Fredrik-Reinholdsen/Vesper/mechanics/Vesper.FCStd

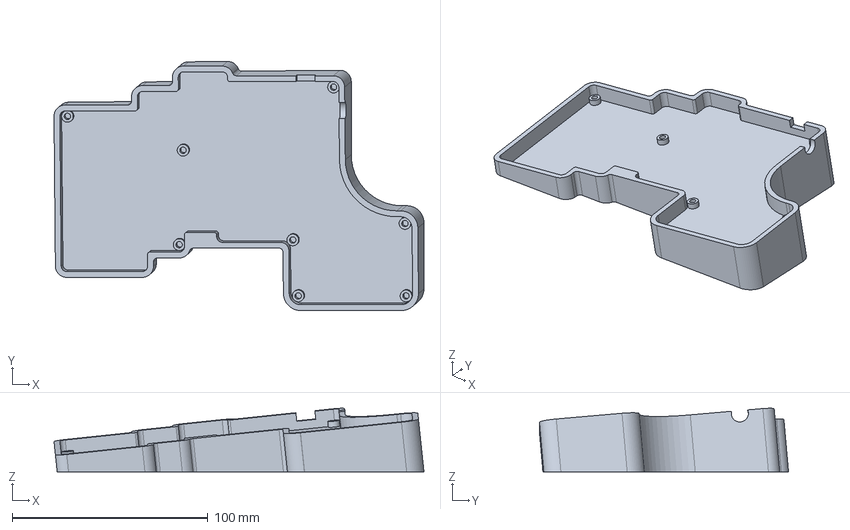
[picture p1: CAD file, 2026-06-29]
mechanics/Vesper.FCStd
189.0 x 127.3 x 32.5 mm
