Fredrik-Reinholdsen/Vesper/mechanics/Vesper_L_Top.FCStd

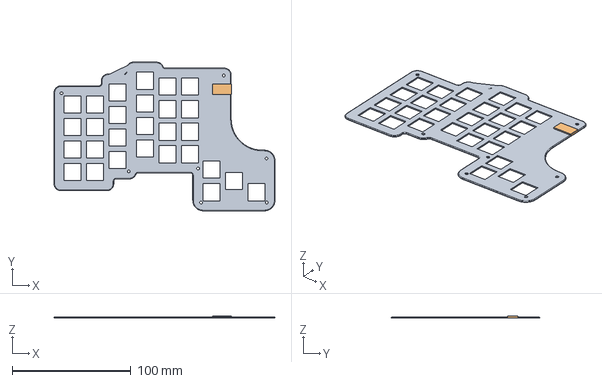
[picture p2: CAD file, 2026-06-29]
mechanics/Vesper_L_Top.FCStd
186.4 x 125.4 x 2.00 mm
TRRSBody
