Fredrik-Reinholdsen/Vesper/(list of files, cad)

Other CAD files:
mechanics/Vesper-L.stl
