Fredrik-Reinholdsen/Vesper/electronics/Schematic.pdf/Kallisto_V2.pdf

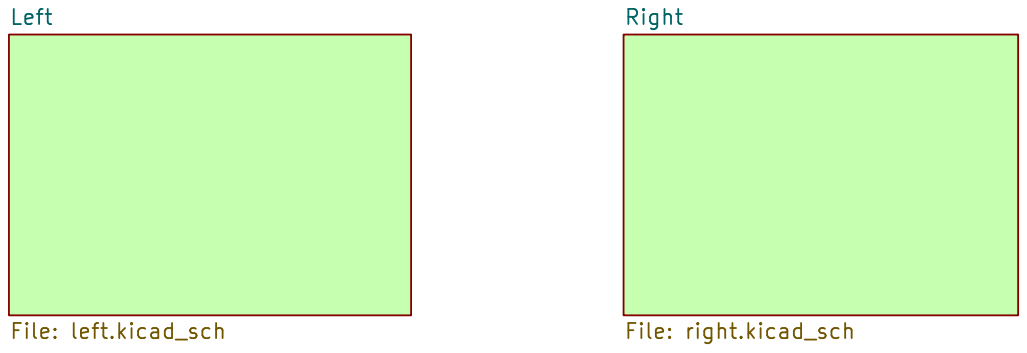
[picture p3: page 1]

Id: 1/5 Title: File: Kallisto_V2.kicad_sch Sheet: /

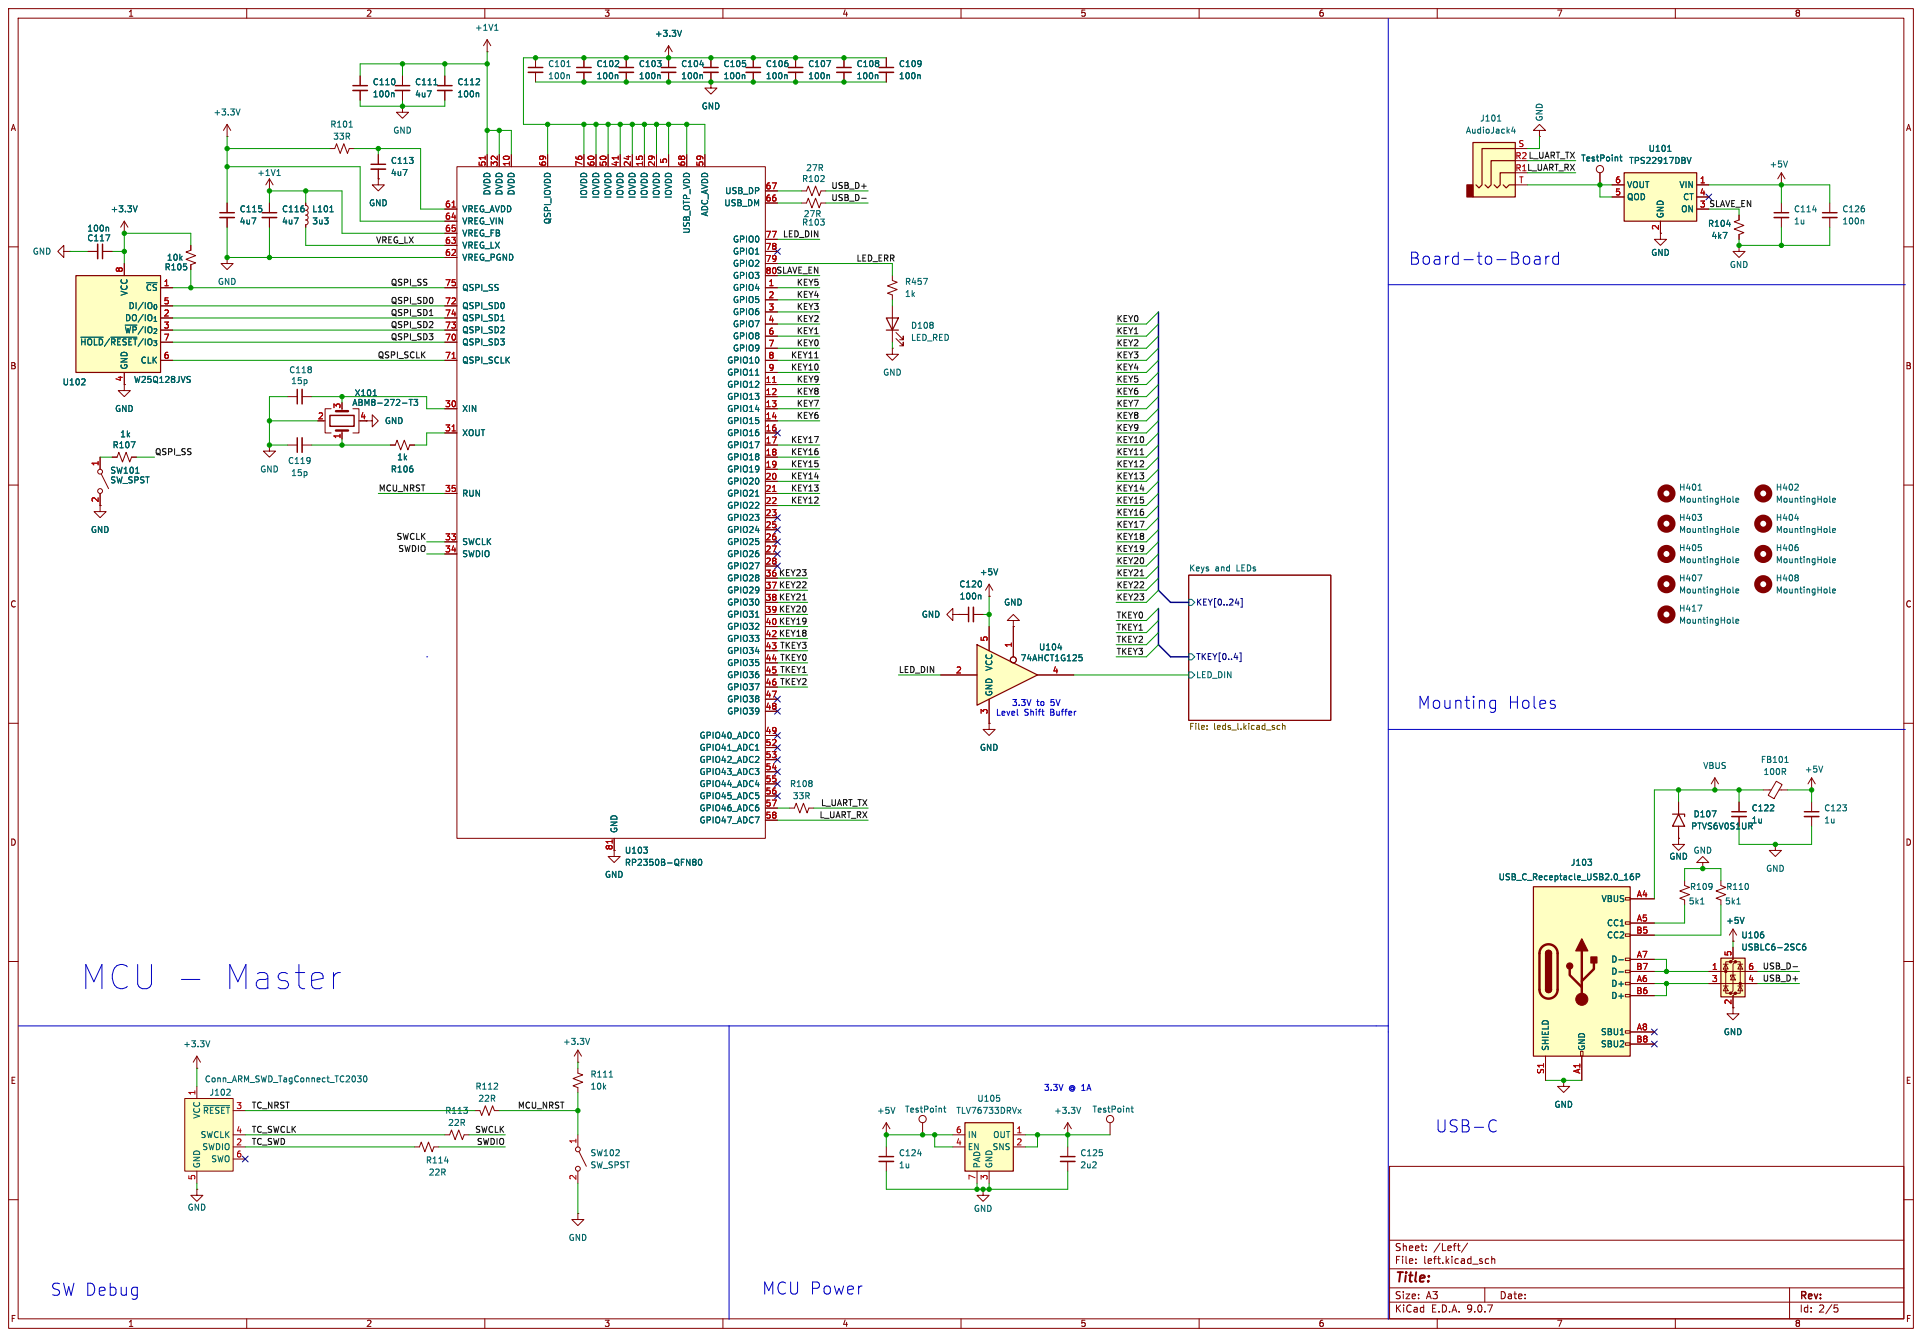
[picture p4: page 2]

4 U103 RP2350B-QFN80 GND 81 VREG_AVDD 61 VREG_VIN 64 VREG_FB 65 VREG_LX 63 VREG_PGND 62 QSPI_SS 75 QSPI_SD0 72 QSPI_SD1 74 QSPI_SD2 73 QSPI_SD3 70 QSPI_SCLK 71 XIN 30 XOUT 31 RUN 35 SWCLK 33 SWDIO 34 DVDD 51 DVDD 32 DVDD 10 QSPI_IOVDD 69 IOVDD 76 IOVDD 60 IOVDD 50 IOVDD 41 IOVDD 24 IOVDD 15 IOVDD 29 IOVDD

4k7 GND
H406 MountingHole H404 MountingHole H408 MountingHole H402 MountingHole GND GND

~{CS}1 DI/IO_{0}5 DO/IO_{1}2 ~{WP}/IO_{2} 3 ~{HOLD}/~{RESET}/IO_{3} 7 CLK 6 VCC

Level Shift Buffer GND

5 ~{RESET}3 SWCLK 4 SWDIO 2 SWO 6

Id: 2/5 Title: File: left.kicad_sch Sheet: /Left/

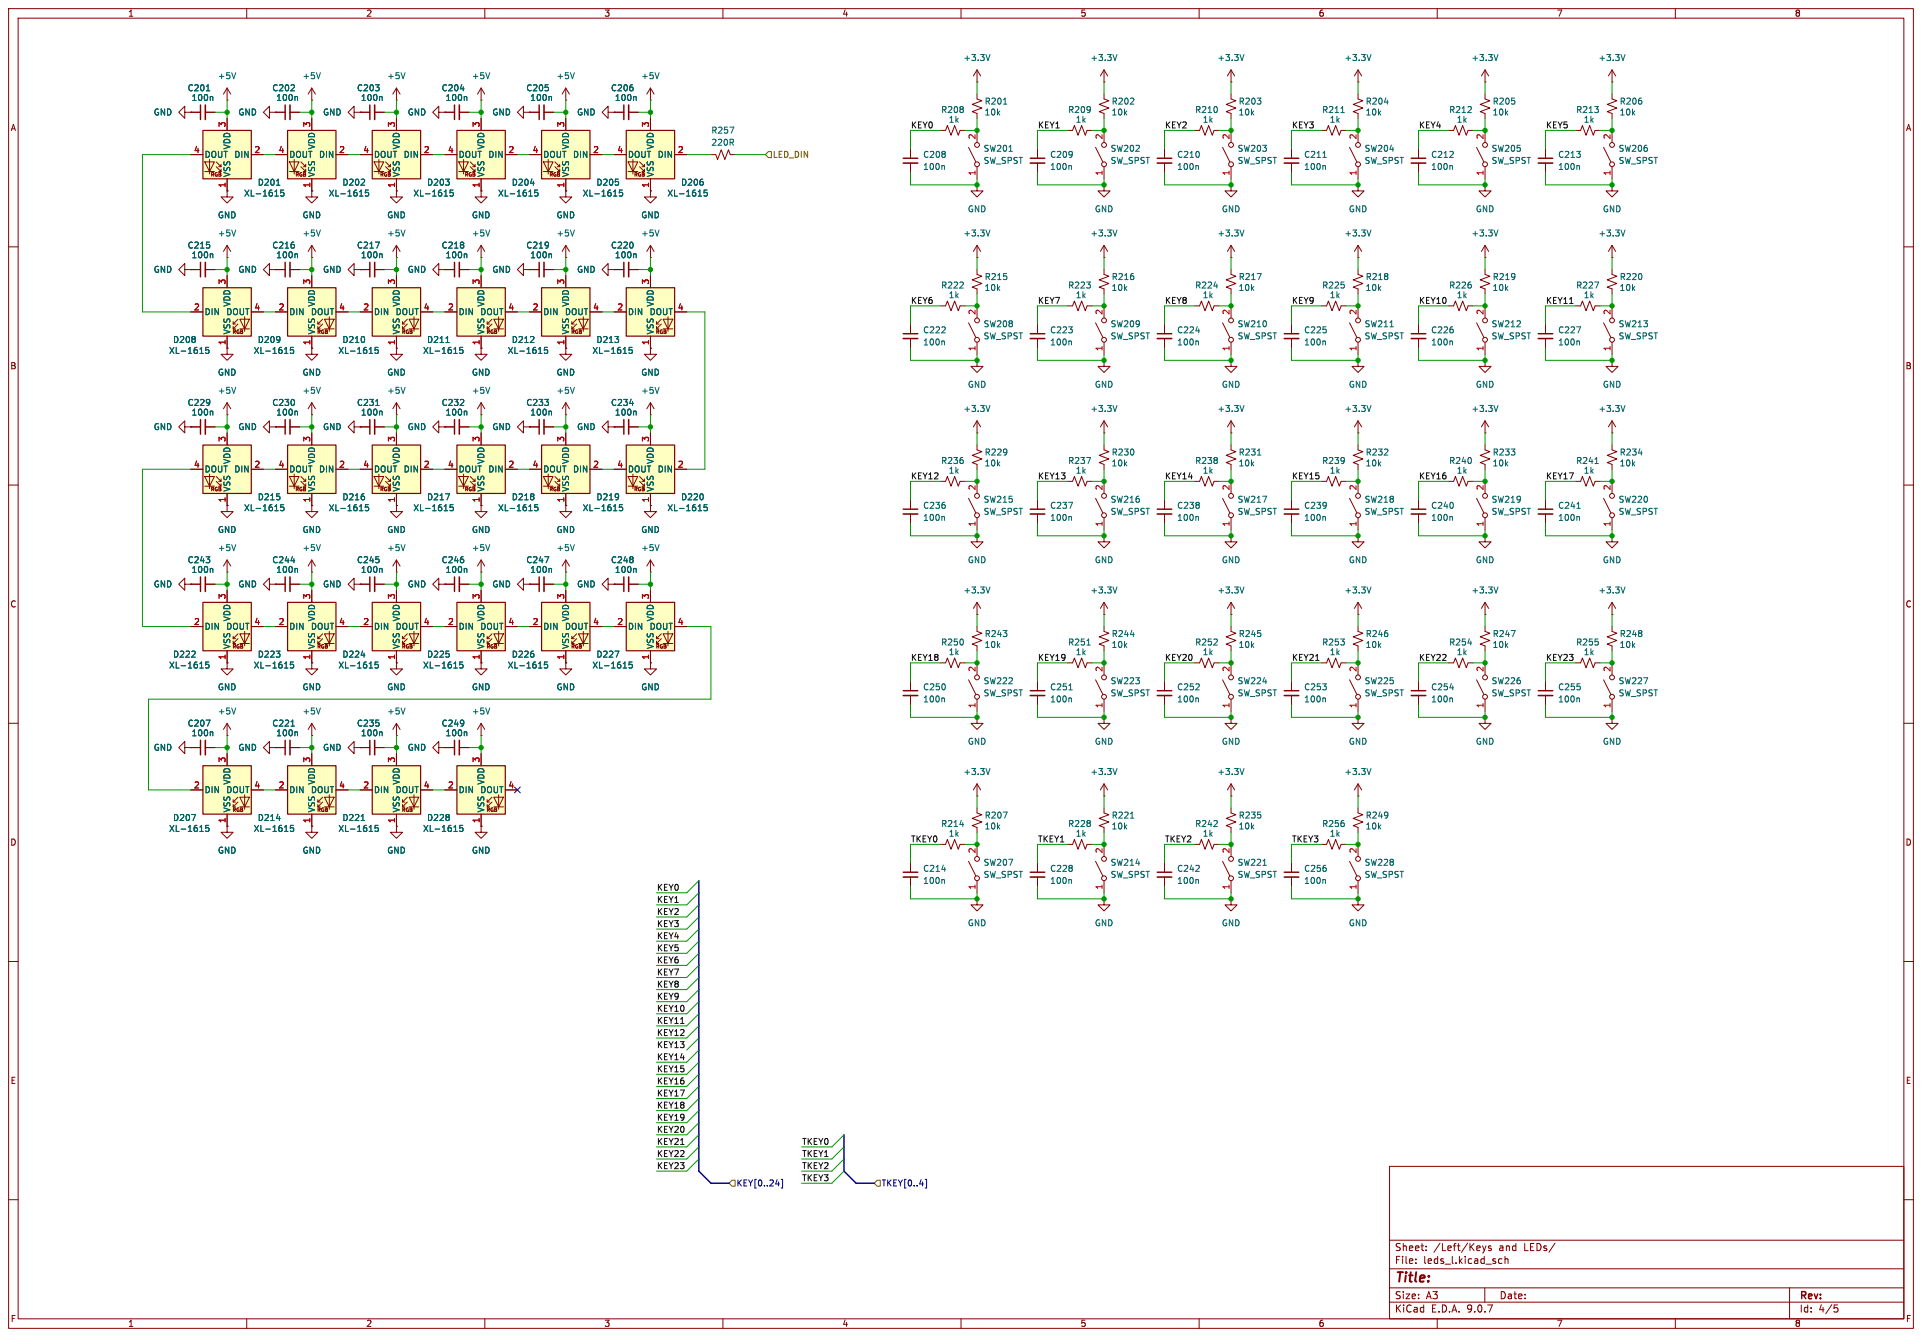
[picture p5: page 3]

1 DOUT 4 D204 XL-1615 GND GND

1 DOUT 4D206 XL-1615 DIN 2 VDD

1 DOUT 4 D208 XL-1615 GND GND

1 DOUT 4 D210 XL-1615 DIN 2 VDD

1 DOUT 4 D212 XL-1615 GND GND

1 DOUT 4 D215 XL-1615 +5V +5V GND GND GND GND

1 DOUT 4 GND GND GND GND

1 DOUT 4 D222 XL-1615 DIN 2 VDD

1 DOUT 4D224 XL-1615 DIN 2 VDD

1 DOUT 4 D225 XL-1615 DIN 2 VDD

1 DOUT 4D226 XL-1615 DIN 2 VDD

1 DOUT 4 GND GND GND

1 DOUT 4 D228 XL-1615 GND GND

1 DOUT 4D221 XL-1615 DIN 2 VDD

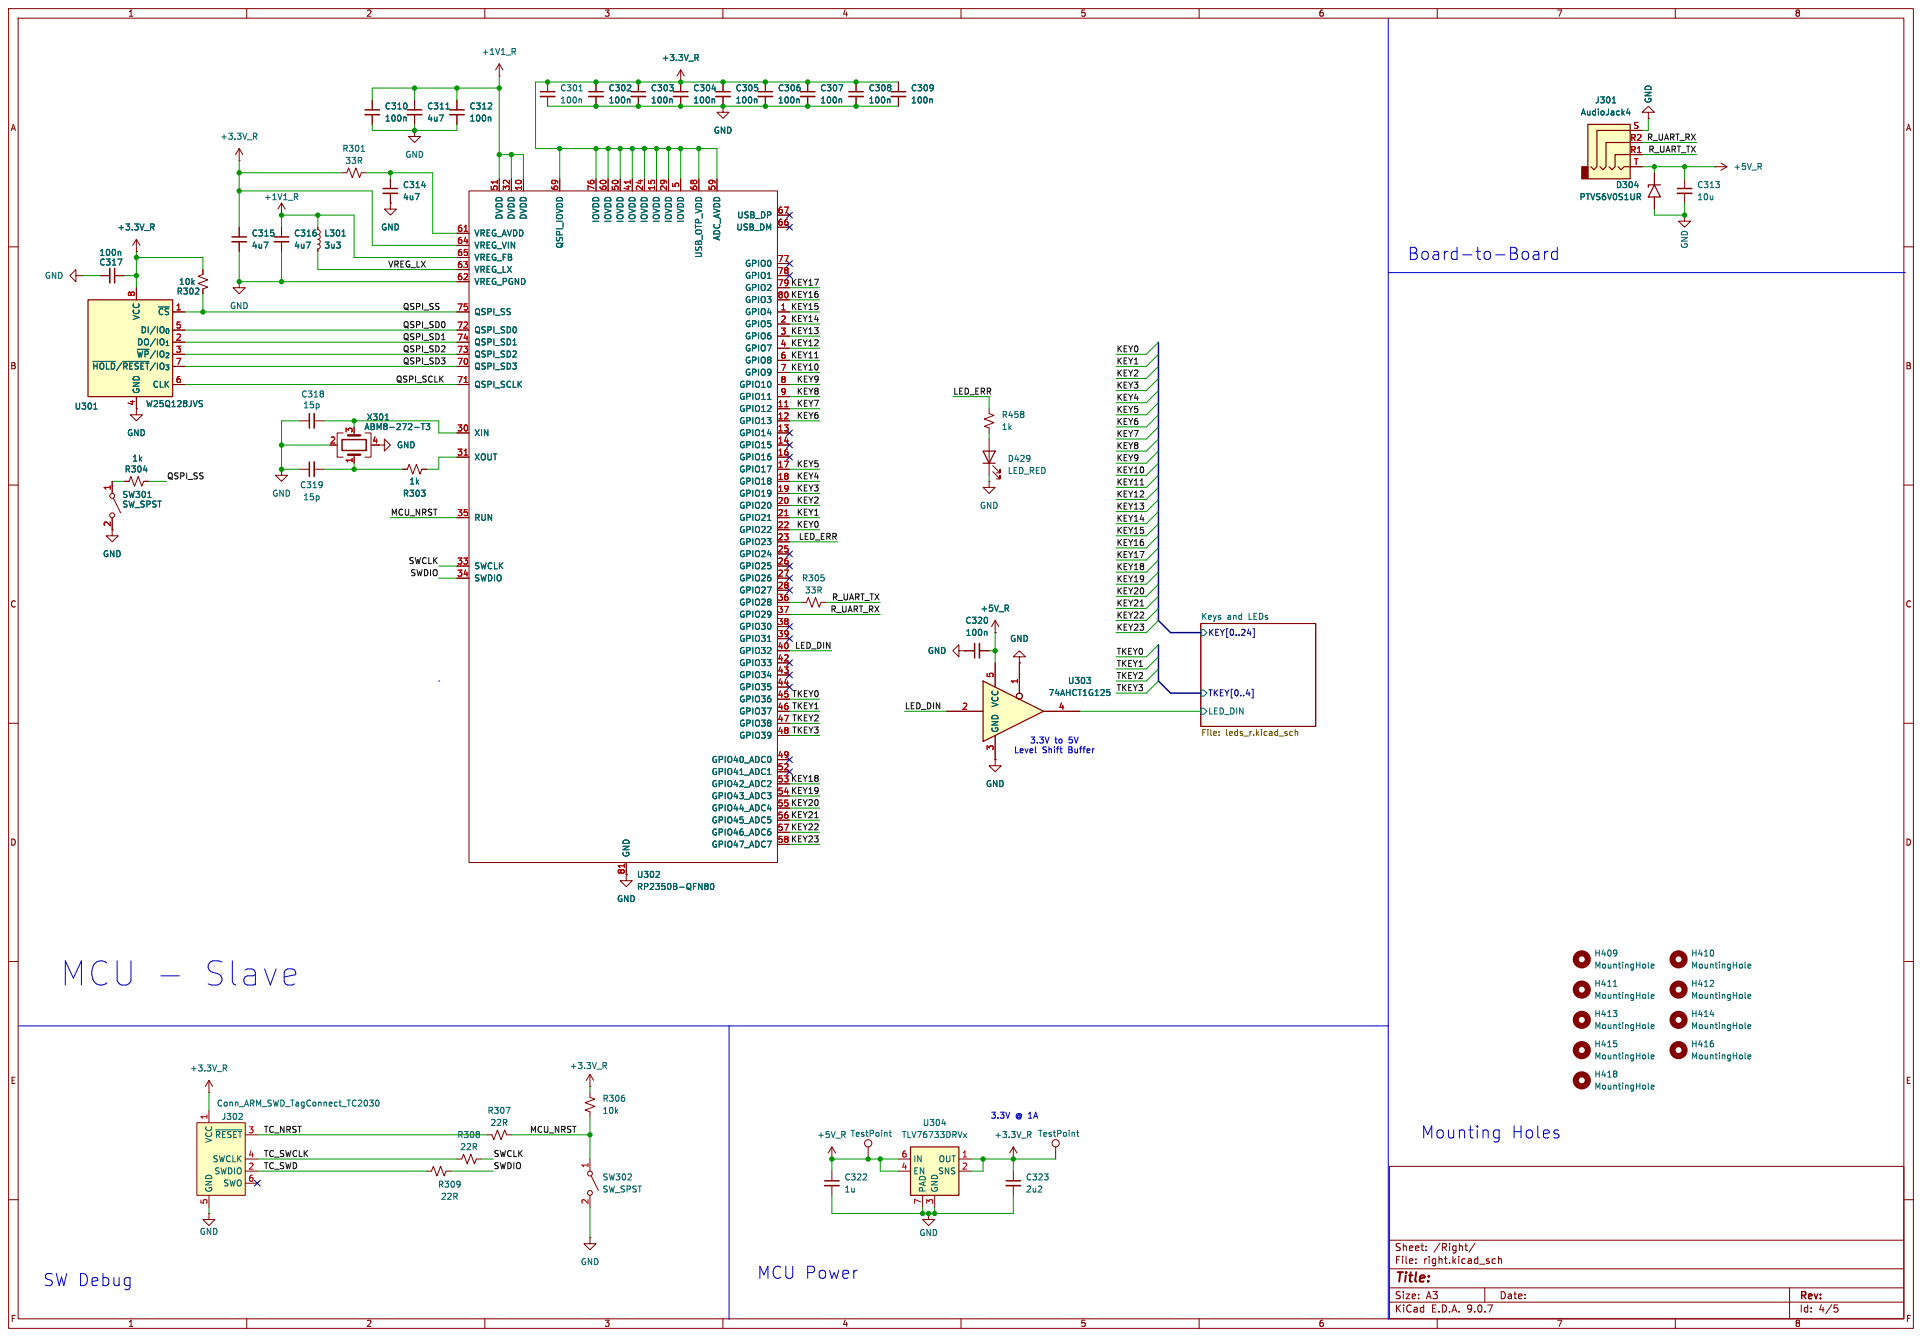
[picture p6: page 4]
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

Keys and LEDs File: leds_r.kicad_sch
KEY[0..24] LED_DIN

5 ~{RESET}3 SWCLK 4 SWDIO 2 SWO 6

Id: 4/5 Title: File: right.kicad_sch Sheet: /Right/

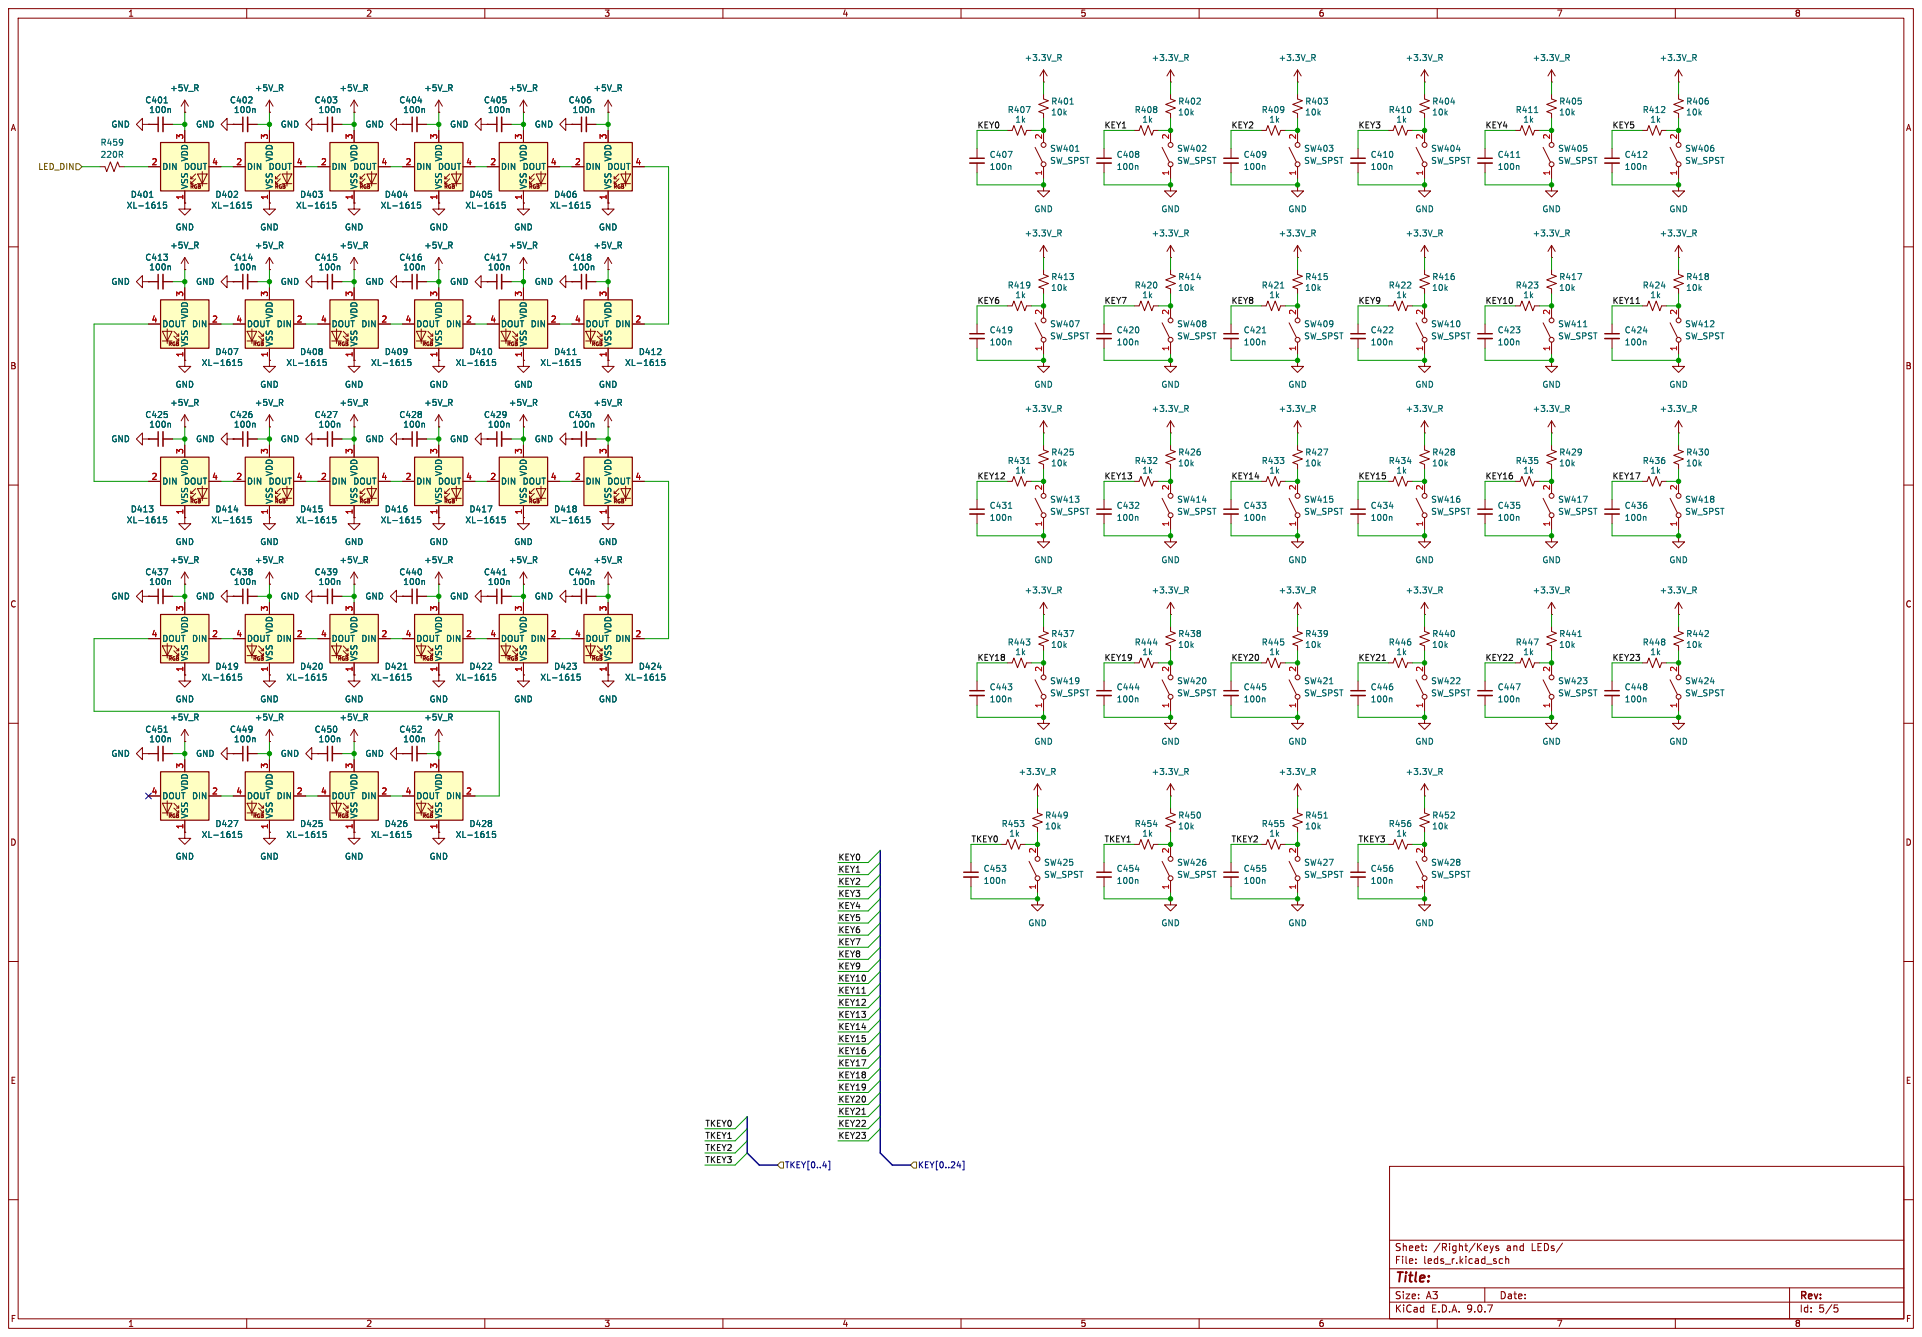
[picture p7: page 5]

1 DOUT 4 D409 XL-1615 DIN 2 VDD

1 DOUT 4 D419 XL-1615 GND GND

1 DOUT 4 D411 XL-1615 DIN 2 VDD

1 DOUT 4 GND GND GND

1 DOUT 4 D409 XL-1615 GND GND

1 DOUT 4 D414 XL-1615 GND GND

1 DOUT 4 D428 XL-1615 GND GND GND GND

1 DOUT 4 D420 XL-1615 DIN 2 VDD

1 DOUT 4 D423 XL-1615 DIN 2 VDD

1 DOUT 4 D422 XL-1615 GND GND
