Fredrik-Reinholdsen/Vesper/electronics/leds_l.kicad_sch

## KiCad design electronics/leds_l.kicad_sch (2026-06-29)

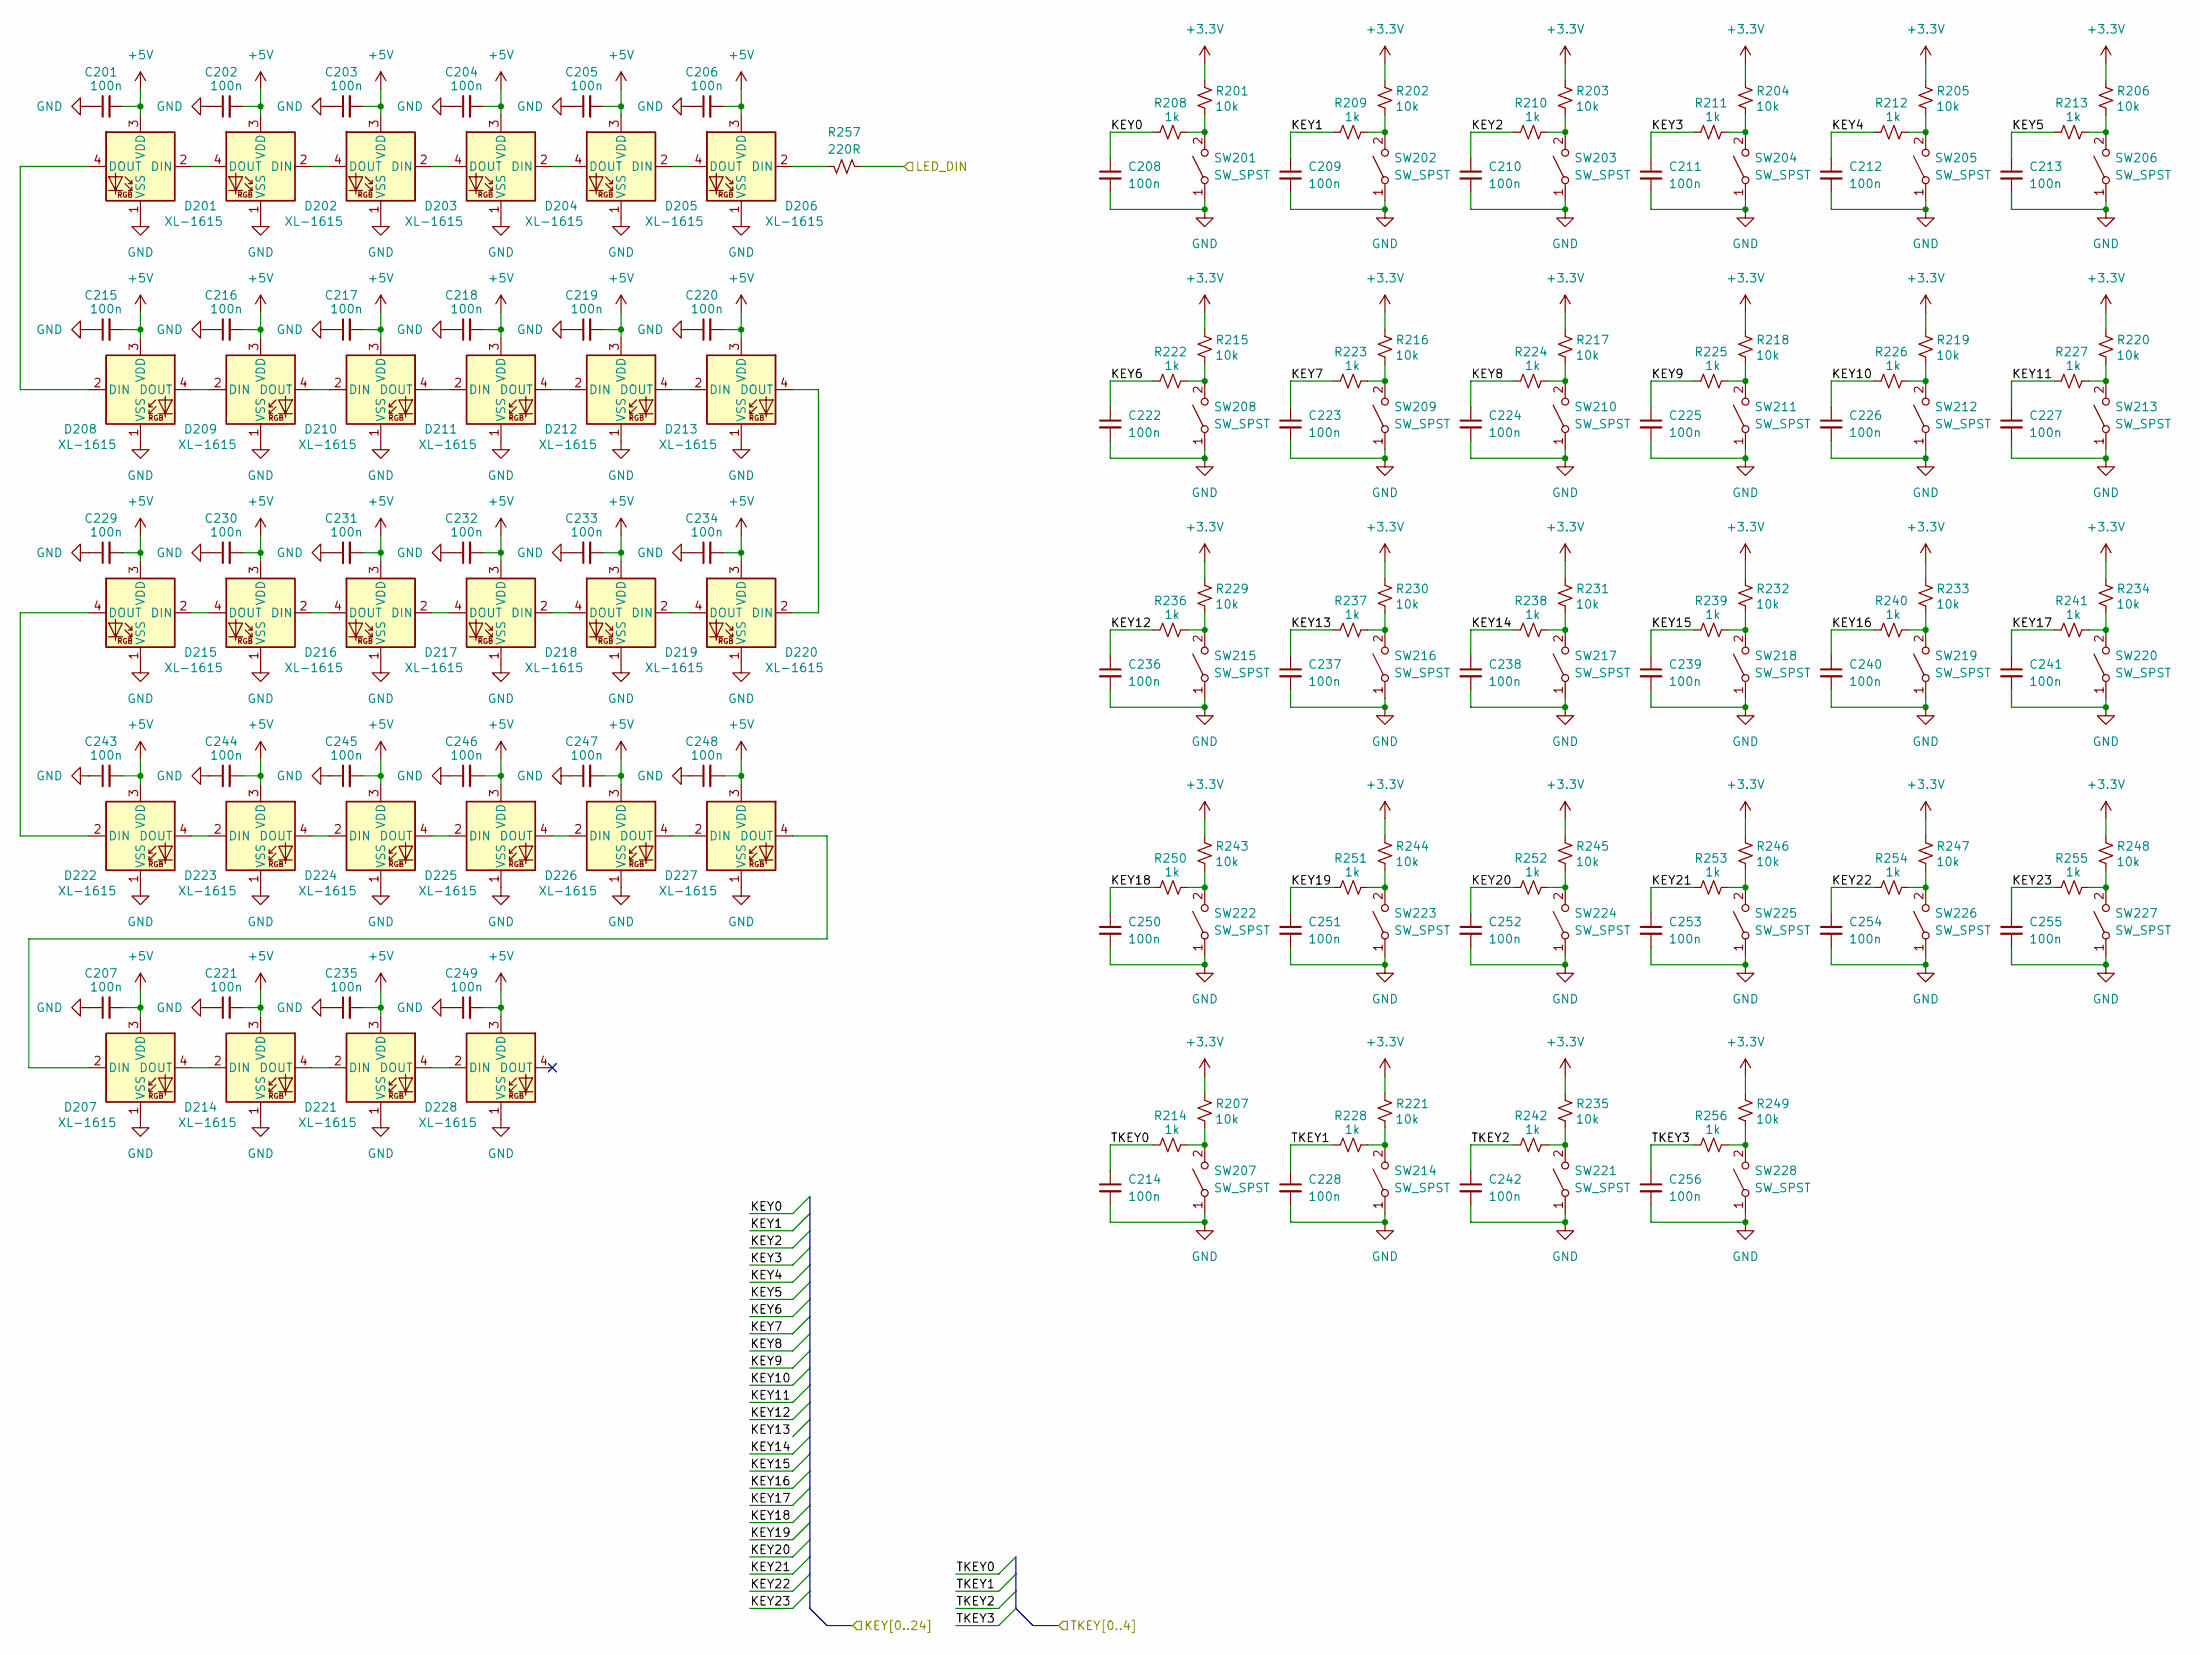
[picture p8: schematic leds_l.kicad_sch]

Parts:
C201, C202, C203, C204, C205, C206, C207, C208, C209, C210, C211, C212, C213, C214, C215, C216, C217, C218, C219, C220, C221, C222, C223, C224, C225, C226, C227, C228, C229, C230, C231, C232, C233, C234, C235, C236, C237, C238, C239, C240, C241, C242, C243, C244, C245, C246, C247, C248, C249, C250, C251, C252, C253, C254, C255, C256: 100n; C_0402_1005Metric; LCSC C1525
D201, D202, D203, D204, D205, D206, D207, D208, D209, D210, D211, D212, D213, D214, D215, D216, D217, D218, D219, D220, D221, D222, D223, D224, D225, D226, D227, D228: XL-1615; XL_1615RGBC; LCSC C5349954
R201, R202, R203, R204, R205, R206, R207, R215, R216, R217, R218, R219, R220, R221, R229, R230, R231, R232, R233, R234, R235, R243, R244, R245, R246, R247, R248, R249: 10k; R_0402_1005Metric; LCSC C25744
R208, R209, R210, R211, R212, R213, R214, R222, R223, R224, R225, R226, R227, R228, R236, R237, R238, R239, R240, R241, R242, R250, R251, R252, R253, R254, R255, R256: 1k; R_0402_1005Metric; LCSC C11702
R257: 220R; R_0402_1005Metric; LCSC C25091
SW201, SW202, SW203, SW204, SW205, SW206, SW207, SW208, SW209, SW210, SW211, SW212, SW213, SW214, SW215, SW216, SW217, SW218, SW219, SW220, SW221, SW222, SW223, SW224, SW225, SW226, SW227, SW228: SW_SPST; SW_PG1350

Connections:
+3.3V: R201.2, R202.2, R203.2, R204.2, R205.2, R206.2, R207.2, R215.2, R216.2, R217.2, R218.2, R219.2, R220.2, R221.2, R229.2, R230.2, R231.2, R232.2, R233.2, R234.2, R235.2, R243.2, R244.2, R245.2, R246.2, R247.2, R248.2, R249.2
+5V: C201.2, C202.2, C203.2, C204.2, C205.2, C206.2, C207.2, C215.2, C216.2, C217.2, C218.2, C219.2, C220.2, C221.2, C229.2, C230.2, C231.2, C232.2, C233.2, C234.2, C235.2, C243.2, C244.2, C245.2, C246.2, C247.2, C248.2, C249.2, D201.3 (VDD), D202.3 (VDD), D203.3 (VDD), D204.3 (VDD), D205.3 (VDD), D206.3 (VDD), D207.3 (VDD), D208.3 (VDD), D209.3 (VDD), D210.3 (VDD), D211.3 (VDD), D212.3 (VDD), D213.3 (VDD), D214.3 (VDD), D215.3 (VDD), D216.3 (VDD), D217.3 (VDD), D218.3 (VDD), D219.3 (VDD), D220.3 (VDD), D221.3 (VDD), D222.3 (VDD), D223.3 (VDD), D224.3 (VDD), D225.3 (VDD), D226.3 (VDD), D227.3 (VDD), D228.3 (VDD)
GND: C201.1, C202.1, C203.1, C204.1, C205.1, C206.1, C207.1, C208.2, C209.2, C210.2, C211.2, C212.2, C213.2, C214.2, C215.1, C216.1, C217.1, C218.1, C219.1, C220.1, C221.1, C222.2, C223.2, C224.2, C225.2, C226.2, C227.2, C228.2, C229.1, C230.1, C231.1, C232.1, C233.1, C234.1, C235.1, C236.2, C237.2, C238.2, C239.2, C240.2, C241.2, C242.2, C243.1, C244.1, C245.1, C246.1, C247.1, C248.1, C249.1, C250.2, C251.2, C252.2, C253.2, C254.2, C255.2, C256.2, D201.1 (VSS), D202.1 (VSS), D203.1 (VSS), D204.1 (VSS), D205.1 (VSS), D206.1 (VSS), D207.1 (VSS), D208.1 (VSS), D209.1 (VSS), D210.1 (VSS), D211.1 (VSS), D212.1 (VSS), D213.1 (VSS), D214.1 (VSS), D215.1 (VSS), D216.1 (VSS), D217.1 (VSS), D218.1 (VSS), D219.1 (VSS), D220.1 (VSS), D221.1 (VSS), D222.1 (VSS), D223.1 (VSS), D224.1 (VSS), D225.1 (VSS), D226.1 (VSS), D227.1 (VSS), D228.1 (VSS), SW201.1 (A), SW202.1 (A), SW203.1 (A), SW204.1 (A), SW205.1 (A), SW206.1 (A), SW207.1 (A), SW208.1 (A), SW209.1 (A), SW210.1 (A), SW211.1 (A), SW212.1 (A), SW213.1 (A), SW214.1 (A), SW215.1 (A), SW216.1 (A), SW217.1 (A), SW218.1 (A), SW219.1 (A), SW220.1 (A), SW221.1 (A), SW222.1 (A), SW223.1 (A), SW224.1 (A), SW225.1 (A), SW226.1 (A), SW227.1 (A), SW228.1 (A)
KEY0: C208.1, R208.1
KEY1: C209.1, R209.1
KEY2: C210.1, R210.1
KEY3: C211.1, R211.1
KEY4: C212.1, R212.1
KEY5: C213.1, R213.1
KEY6: C222.1, R222.1
KEY7: C223.1, R223.1
KEY8: C224.1, R224.1
KEY9: C225.1, R225.1
KEY10: C226.1, R226.1
KEY11: C227.1, R227.1
KEY12: C236.1, R236.1
KEY13: C237.1, R237.1
KEY14: C238.1, R238.1
KEY15: C239.1, R239.1
KEY16: C240.1, R240.1
KEY17: C241.1, R241.1
KEY18: C250.1, R250.1
KEY19: C251.1, R251.1
KEY20: C252.1, R252.1
KEY21: C253.1, R253.1
KEY22: C254.1, R254.1
KEY23: C255.1, R255.1
LED_DIN: R257.1
unnamed: D201.2 (DIN), D202.4 (DOUT)
unnamed: D201.4 (DOUT), D208.2 (DIN)
unnamed: D202.2 (DIN), D203.4 (DOUT)
unnamed: D203.2 (DIN), D204.4 (DOUT)
unnamed: D204.2 (DIN), D205.4 (DOUT)
unnamed: D205.2 (DIN), D206.4 (DOUT)
unnamed: D206.2 (DIN), R257.2
unnamed: D207.2 (DIN), D227.4 (DOUT)
unnamed: D207.4 (DOUT), D214.2 (DIN)
unnamed: D208.4 (DOUT), D209.2 (DIN)
unnamed: D209.4 (DOUT), D210.2 (DIN)
unnamed: D210.4 (DOUT), D211.2 (DIN)
unnamed: D211.4 (DOUT), D212.2 (DIN)
unnamed: D212.4 (DOUT), D213.2 (DIN)
unnamed: D213.4 (DOUT), D220.2 (DIN)
unnamed: D214.4 (DOUT), D221.2 (DIN)
unnamed: D215.2 (DIN), D216.4 (DOUT)
unnamed: D215.4 (DOUT), D222.2 (DIN)
unnamed: D216.2 (DIN), D217.4 (DOUT)
unnamed: D217.2 (DIN), D218.4 (DOUT)
unnamed: D218.2 (DIN), D219.4 (DOUT)
unnamed: D219.2 (DIN), D220.4 (DOUT)
unnamed: D221.4 (DOUT), D228.2 (DIN)
unnamed: D222.4 (DOUT), D223.2 (DIN)
unnamed: D223.4 (DOUT), D224.2 (DIN)
unnamed: D224.4 (DOUT), D225.2 (DIN)
unnamed: D225.4 (DOUT), D226.2 (DIN)
unnamed: D226.4 (DOUT), D227.2 (DIN)
unnamed: R201.1, R208.2, SW201.2 (B)
unnamed: R202.1, R209.2, SW202.2 (B)
unnamed: R203.1, R210.2, SW203.2 (B)
unnamed: R204.1, R211.2, SW204.2 (B)
unnamed: R205.1, R212.2, SW205.2 (B)
unnamed: R206.1, R213.2, SW206.2 (B)
unnamed: R207.1, R214.2, SW207.2 (B)
unnamed: R215.1, R222.2, SW208.2 (B)
unnamed: R216.1, R223.2, SW209.2 (B)
unnamed: R217.1, R224.2, SW210.2 (B)
unnamed: R218.1, R225.2, SW211.2 (B)
unnamed: R219.1, R226.2, SW212.2 (B)
unnamed: R220.1, R227.2, SW213.2 (B)
unnamed: R221.1, R228.2, SW214.2 (B)
unnamed: R229.1, R236.2, SW215.2 (B)
unnamed: R230.1, R237.2, SW216.2 (B)
unnamed: R231.1, R238.2, SW217.2 (B)
unnamed: R232.1, R239.2, SW218.2 (B)
unnamed: R233.1, R240.2, SW219.2 (B)
unnamed: R234.1, R241.2, SW220.2 (B)
unnamed: R235.1, R242.2, SW221.2 (B)
unnamed: R243.1, R250.2, SW222.2 (B)
unnamed: R244.1, R251.2, SW223.2 (B)
unnamed: R245.1, R252.2, SW224.2 (B)
unnamed: R246.1, R253.2, SW225.2 (B)
unnamed: R247.1, R254.2, SW226.2 (B)
unnamed: R248.1, R255.2, SW227.2 (B)
unnamed: R249.1, R256.2, SW228.2 (B)
TKEY0: C214.1, R214.1
TKEY1: C228.1, R228.1
TKEY2: C242.1, R242.1
TKEY3: C256.1, R256.1
