Fredrik-Reinholdsen/Vesper/electronics/leds_r.kicad_sch

## KiCad design electronics/leds_r.kicad_sch (2026-06-29)

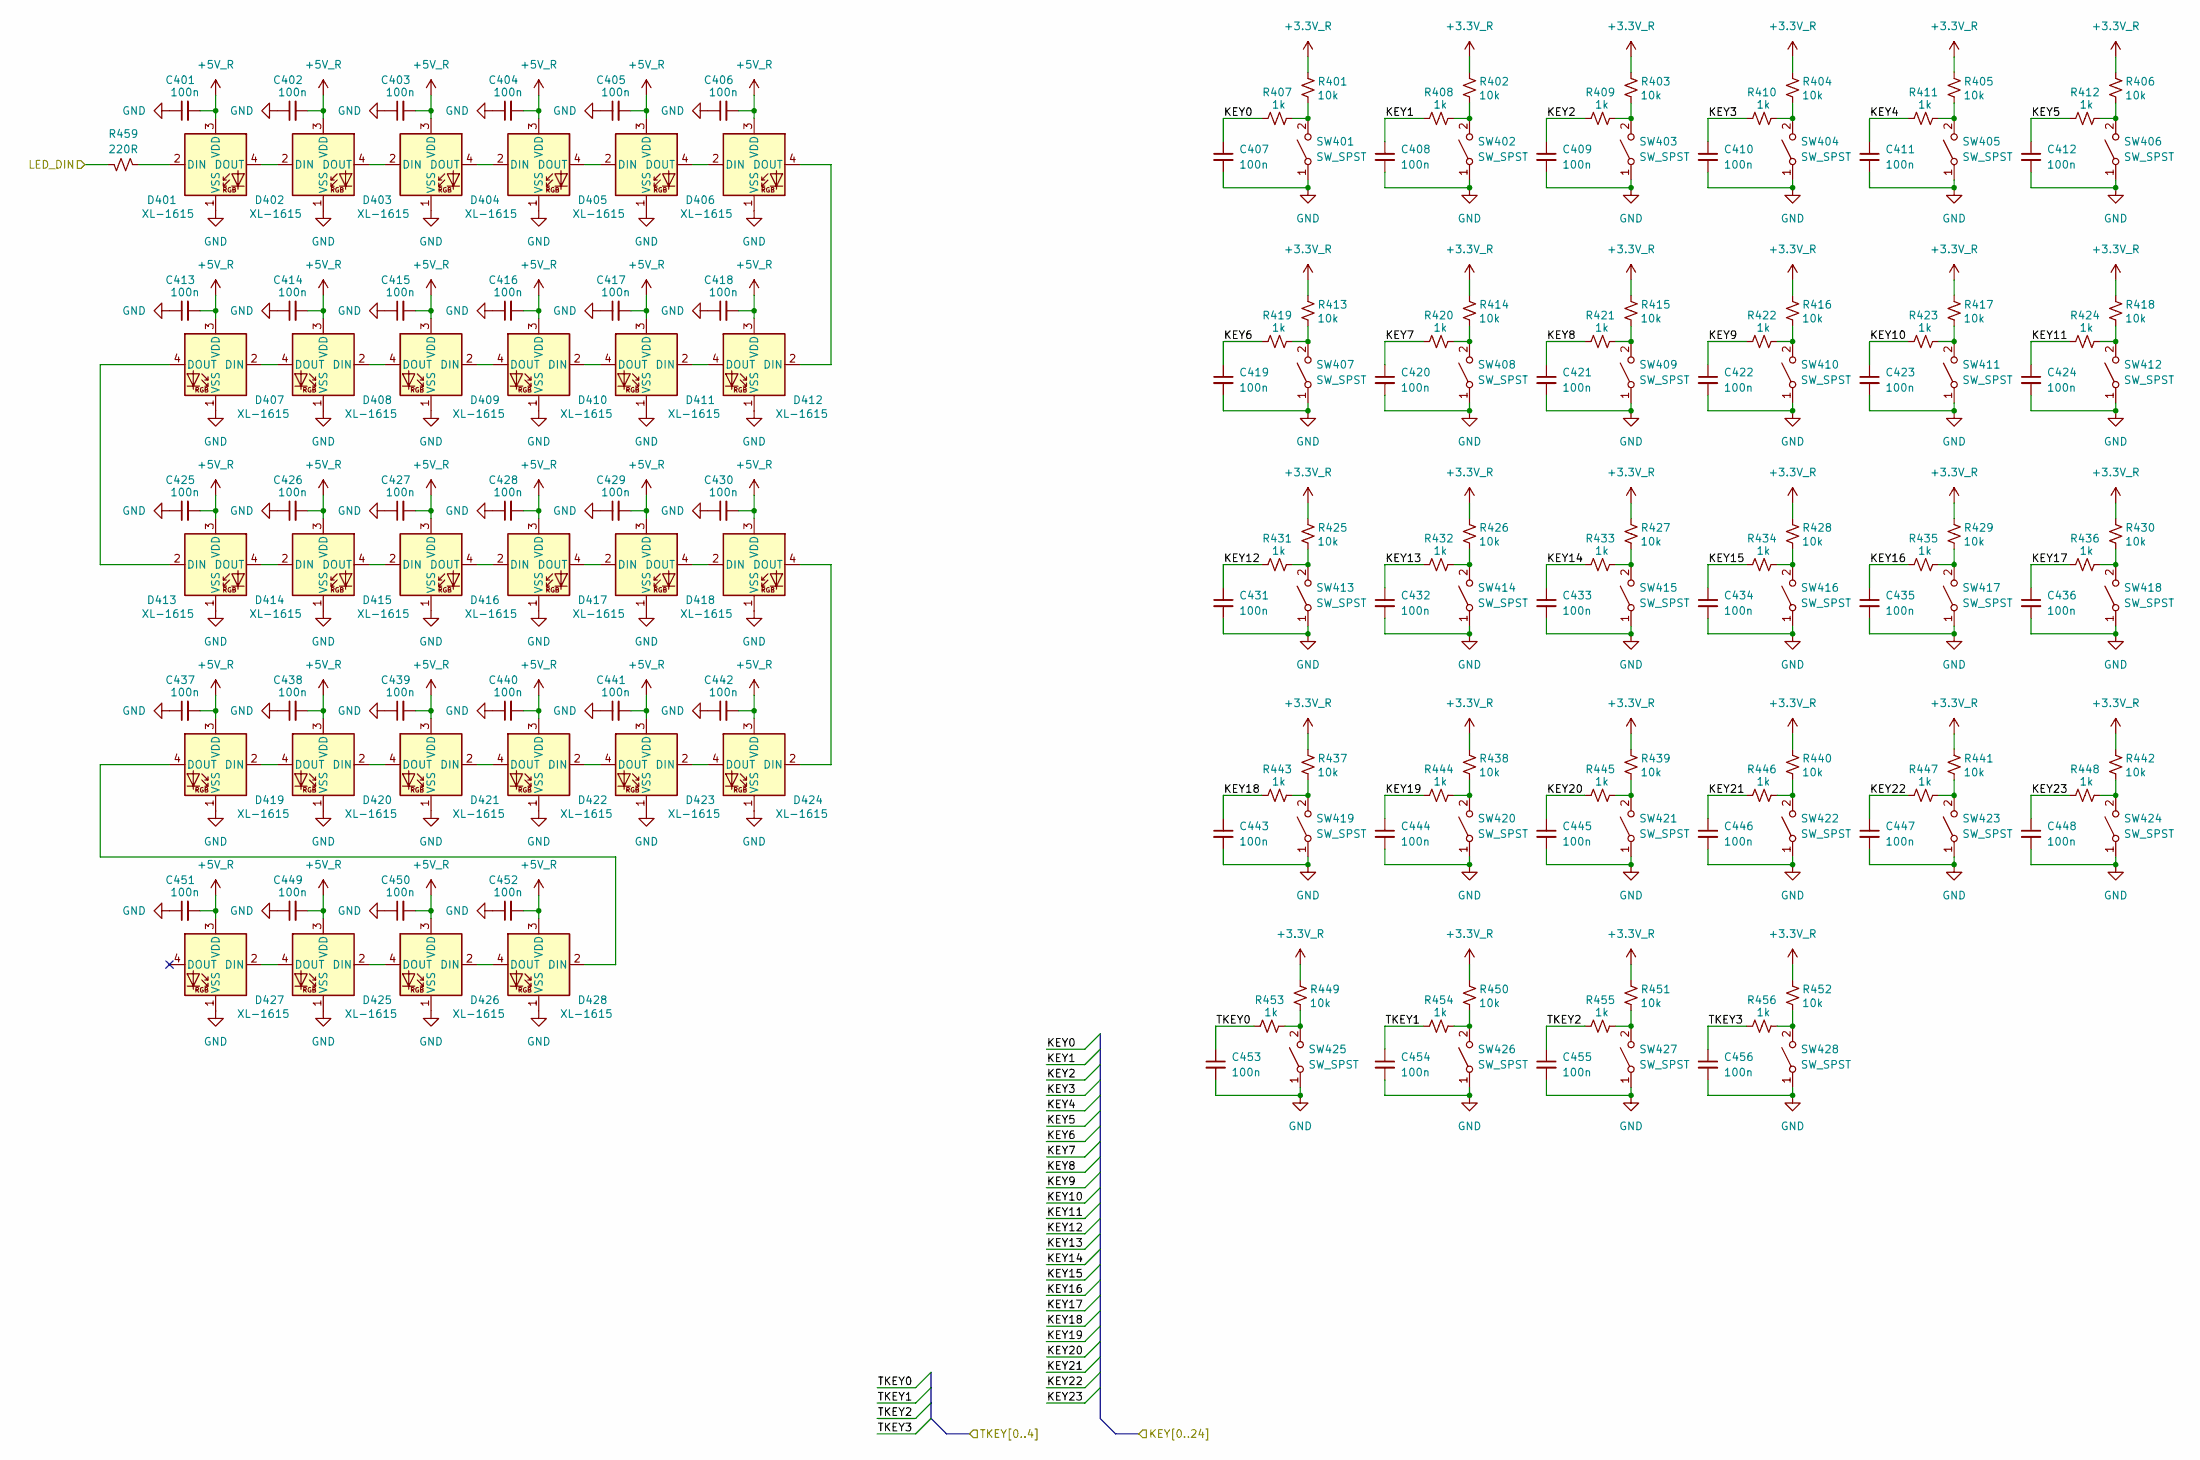
[picture p9: schematic leds_r.kicad_sch]

Parts:
C401, C402, C403, C404, C405, C406, C407, C408, C409, C410, C411, C412, C413, C414, C415, C416, C417, C418, C419, C420, C421, C422, C423, C424, C425, C426, C427, C428, C429, C430, C431, C432, C433, C434, C435, C436, C437, C438, C439, C440, C441, C442, C443, C444, C445, C446, C447, C448, C449, C450, C451, C452, C453, C454, C455, C456: 100n; C_0402_1005Metric; LCSC C1525
D401, D402, D403, D404, D405, D406, D407, D408, D409, D410, D411, D412, D413, D414, D415, D416, D417, D418, D419, D420, D421, D422, D423, D424, D425, D426, D427, D428: XL-1615; XL_1615RGBC; LCSC C5349954
R401, R402, R403, R404, R405, R406, R413, R414, R415, R416, R417, R418, R425, R426, R427, R428, R429, R430, R437, R438, R439, R440, R441, R442, R449, R450, R451, R452: 10k; R_0402_1005Metric; LCSC C25744
R407, R408, R409, R410, R411, R412, R419, R420, R421, R422, R423, R424, R431, R432, R433, R434, R435, R436, R443, R444, R445, R446, R447, R448, R453, R454, R455, R456: 1k; R_0402_1005Metric; LCSC C11702
R459: 220R; R_0402_1005Metric; LCSC C25091
SW401, SW402, SW403, SW404, SW405, SW406, SW407, SW408, SW409, SW410, SW411, SW412, SW413, SW414, SW415, SW416, SW417, SW418, SW419, SW420, SW421, SW422, SW423, SW424, SW425, SW426, SW427, SW428: SW_SPST; SW_PG1350

Connections:
+3.3V_R: R401.2, R402.2, R403.2, R404.2, R405.2, R406.2, R413.2, R414.2, R415.2, R416.2, R417.2, R418.2, R425.2, R426.2, R427.2, R428.2, R429.2, R430.2, R437.2, R438.2, R439.2, R440.2, R441.2, R442.2, R449.2, R450.2, R451.2, R452.2
+5V_R: C401.2, C402.2, C403.2, C404.2, C405.2, C406.2, C413.2, C414.2, C415.2, C416.2, C417.2, C418.2, C425.2, C426.2, C427.2, C428.2, C429.2, C430.2, C437.2, C438.2, C439.2, C440.2, C441.2, C442.2, C449.2, C450.2, C451.2, C452.2, D401.3 (VDD), D402.3 (VDD), D403.3 (VDD), D404.3 (VDD), D405.3 (VDD), D406.3 (VDD), D407.3 (VDD), D408.3 (VDD), D409.3 (VDD), D410.3 (VDD), D411.3 (VDD), D412.3 (VDD), D413.3 (VDD), D414.3 (VDD), D415.3 (VDD), D416.3 (VDD), D417.3 (VDD), D418.3 (VDD), D419.3 (VDD), D420.3 (VDD), D421.3 (VDD), D422.3 (VDD), D423.3 (VDD), D424.3 (VDD), D425.3 (VDD), D426.3 (VDD), D427.3 (VDD), D428.3 (VDD)
GND: C401.1, C402.1, C403.1, C404.1, C405.1, C406.1, C407.2, C408.2, C409.2, C410.2, C411.2, C412.2, C413.1, C414.1, C415.1, C416.1, C417.1, C418.1, C419.2, C420.2, C421.2, C422.2, C423.2, C424.2, C425.1, C426.1, C427.1, C428.1, C429.1, C430.1, C431.2, C432.2, C433.2, C434.2, C435.2, C436.2, C437.1, C438.1, C439.1, C440.1, C441.1, C442.1, C443.2, C444.2, C445.2, C446.2, C447.2, C448.2, C449.1, C450.1, C451.1, C452.1, C453.2, C454.2, C455.2, C456.2, D401.1 (VSS), D402.1 (VSS), D403.1 (VSS), D404.1 (VSS), D405.1 (VSS), D406.1 (VSS), D407.1 (VSS), D408.1 (VSS), D409.1 (VSS), D410.1 (VSS), D411.1 (VSS), D412.1 (VSS), D413.1 (VSS), D414.1 (VSS), D415.1 (VSS), D416.1 (VSS), D417.1 (VSS), D418.1 (VSS), D419.1 (VSS), D420.1 (VSS), D421.1 (VSS), D422.1 (VSS), D423.1 (VSS), D424.1 (VSS), D425.1 (VSS), D426.1 (VSS), D427.1 (VSS), D428.1 (VSS), SW401.1 (A), SW402.1 (A), SW403.1 (A), SW404.1 (A), SW405.1 (A), SW406.1 (A), SW407.1 (A), SW408.1 (A), SW409.1 (A), SW410.1 (A), SW411.1 (A), SW412.1 (A), SW413.1 (A), SW414.1 (A), SW415.1 (A), SW416.1 (A), SW417.1 (A), SW418.1 (A), SW419.1 (A), SW420.1 (A), SW421.1 (A), SW422.1 (A), SW423.1 (A), SW424.1 (A), SW425.1 (A), SW426.1 (A), SW427.1 (A), SW428.1 (A)
KEY0: C407.1, R407.1
KEY1: C408.1, R408.1
KEY2: C409.1, R409.1
KEY3: C410.1, R410.1
KEY4: C411.1, R411.1
KEY5: C412.1, R412.1
KEY6: C419.1, R419.1
KEY7: C420.1, R420.1
KEY8: C421.1, R421.1
KEY9: C422.1, R422.1
KEY10: C423.1, R423.1
KEY11: C424.1, R424.1
KEY12: C431.1, R431.1
KEY13: C432.1, R432.1
KEY14: C433.1, R433.1
KEY15: C434.1, R434.1
KEY16: C435.1, R435.1
KEY17: C436.1, R436.1
KEY18: C443.1, R443.1
KEY19: C444.1, R444.1
KEY20: C445.1, R445.1
KEY21: C446.1, R446.1
KEY22: C447.1, R447.1
KEY23: C448.1, R448.1
LED_DIN: R459.2
unnamed: D401.2 (DIN), R459.1
unnamed: D401.4 (DOUT), D402.2 (DIN)
unnamed: D402.4 (DOUT), D403.2 (DIN)
unnamed: D403.4 (DOUT), D404.2 (DIN)
unnamed: D404.4 (DOUT), D405.2 (DIN)
unnamed: D405.4 (DOUT), D406.2 (DIN)
unnamed: D406.4 (DOUT), D412.2 (DIN)
unnamed: D407.2 (DIN), D408.4 (DOUT)
unnamed: D407.4 (DOUT), D413.2 (DIN)
unnamed: D408.2 (DIN), D409.4 (DOUT)
unnamed: D409.2 (DIN), D410.4 (DOUT)
unnamed: D410.2 (DIN), D411.4 (DOUT)
unnamed: D411.2 (DIN), D412.4 (DOUT)
unnamed: D413.4 (DOUT), D414.2 (DIN)
unnamed: D414.4 (DOUT), D415.2 (DIN)
unnamed: D415.4 (DOUT), D416.2 (DIN)
unnamed: D416.4 (DOUT), D417.2 (DIN)
unnamed: D417.4 (DOUT), D418.2 (DIN)
unnamed: D418.4 (DOUT), D424.2 (DIN)
unnamed: D419.2 (DIN), D420.4 (DOUT)
unnamed: D419.4 (DOUT), D428.2 (DIN)
unnamed: D420.2 (DIN), D421.4 (DOUT)
unnamed: D421.2 (DIN), D422.4 (DOUT)
unnamed: D422.2 (DIN), D423.4 (DOUT)
unnamed: D423.2 (DIN), D424.4 (DOUT)
unnamed: D425.2 (DIN), D426.4 (DOUT)
unnamed: D425.4 (DOUT), D427.2 (DIN)
unnamed: D426.2 (DIN), D428.4 (DOUT)
unnamed: R401.1, R407.2, SW401.2 (B)
unnamed: R402.1, R408.2, SW402.2 (B)
unnamed: R403.1, R409.2, SW403.2 (B)
unnamed: R404.1, R410.2, SW404.2 (B)
unnamed: R405.1, R411.2, SW405.2 (B)
unnamed: R406.1, R412.2, SW406.2 (B)
unnamed: R413.1, R419.2, SW407.2 (B)
unnamed: R414.1, R420.2, SW408.2 (B)
unnamed: R415.1, R421.2, SW409.2 (B)
unnamed: R416.1, R422.2, SW410.2 (B)
unnamed: R417.1, R423.2, SW411.2 (B)
unnamed: R418.1, R424.2, SW412.2 (B)
unnamed: R425.1, R431.2, SW413.2 (B)
unnamed: R426.1, R432.2, SW414.2 (B)
unnamed: R427.1, R433.2, SW415.2 (B)
unnamed: R428.1, R434.2, SW416.2 (B)
unnamed: R429.1, R435.2, SW417.2 (B)
unnamed: R430.1, R436.2, SW418.2 (B)
unnamed: R437.1, R443.2, SW419.2 (B)
unnamed: R438.1, R444.2, SW420.2 (B)
unnamed: R439.1, R445.2, SW421.2 (B)
unnamed: R440.1, R446.2, SW422.2 (B)
unnamed: R441.1, R447.2, SW423.2 (B)
unnamed: R442.1, R448.2, SW424.2 (B)
unnamed: R449.1, R453.2, SW425.2 (B)
unnamed: R450.1, R454.2, SW426.2 (B)
unnamed: R451.1, R455.2, SW427.2 (B)
unnamed: R452.1, R456.2, SW428.2 (B)
TKEY0: C453.1, R453.1
TKEY1: C454.1, R454.1
TKEY2: C455.1, R455.1
TKEY3: C456.1, R456.1
