Fredrik-Reinholdsen/Vesper/electronics/left.kicad_sch

## KiCad design electronics/left.kicad_sch (2026-06-29)

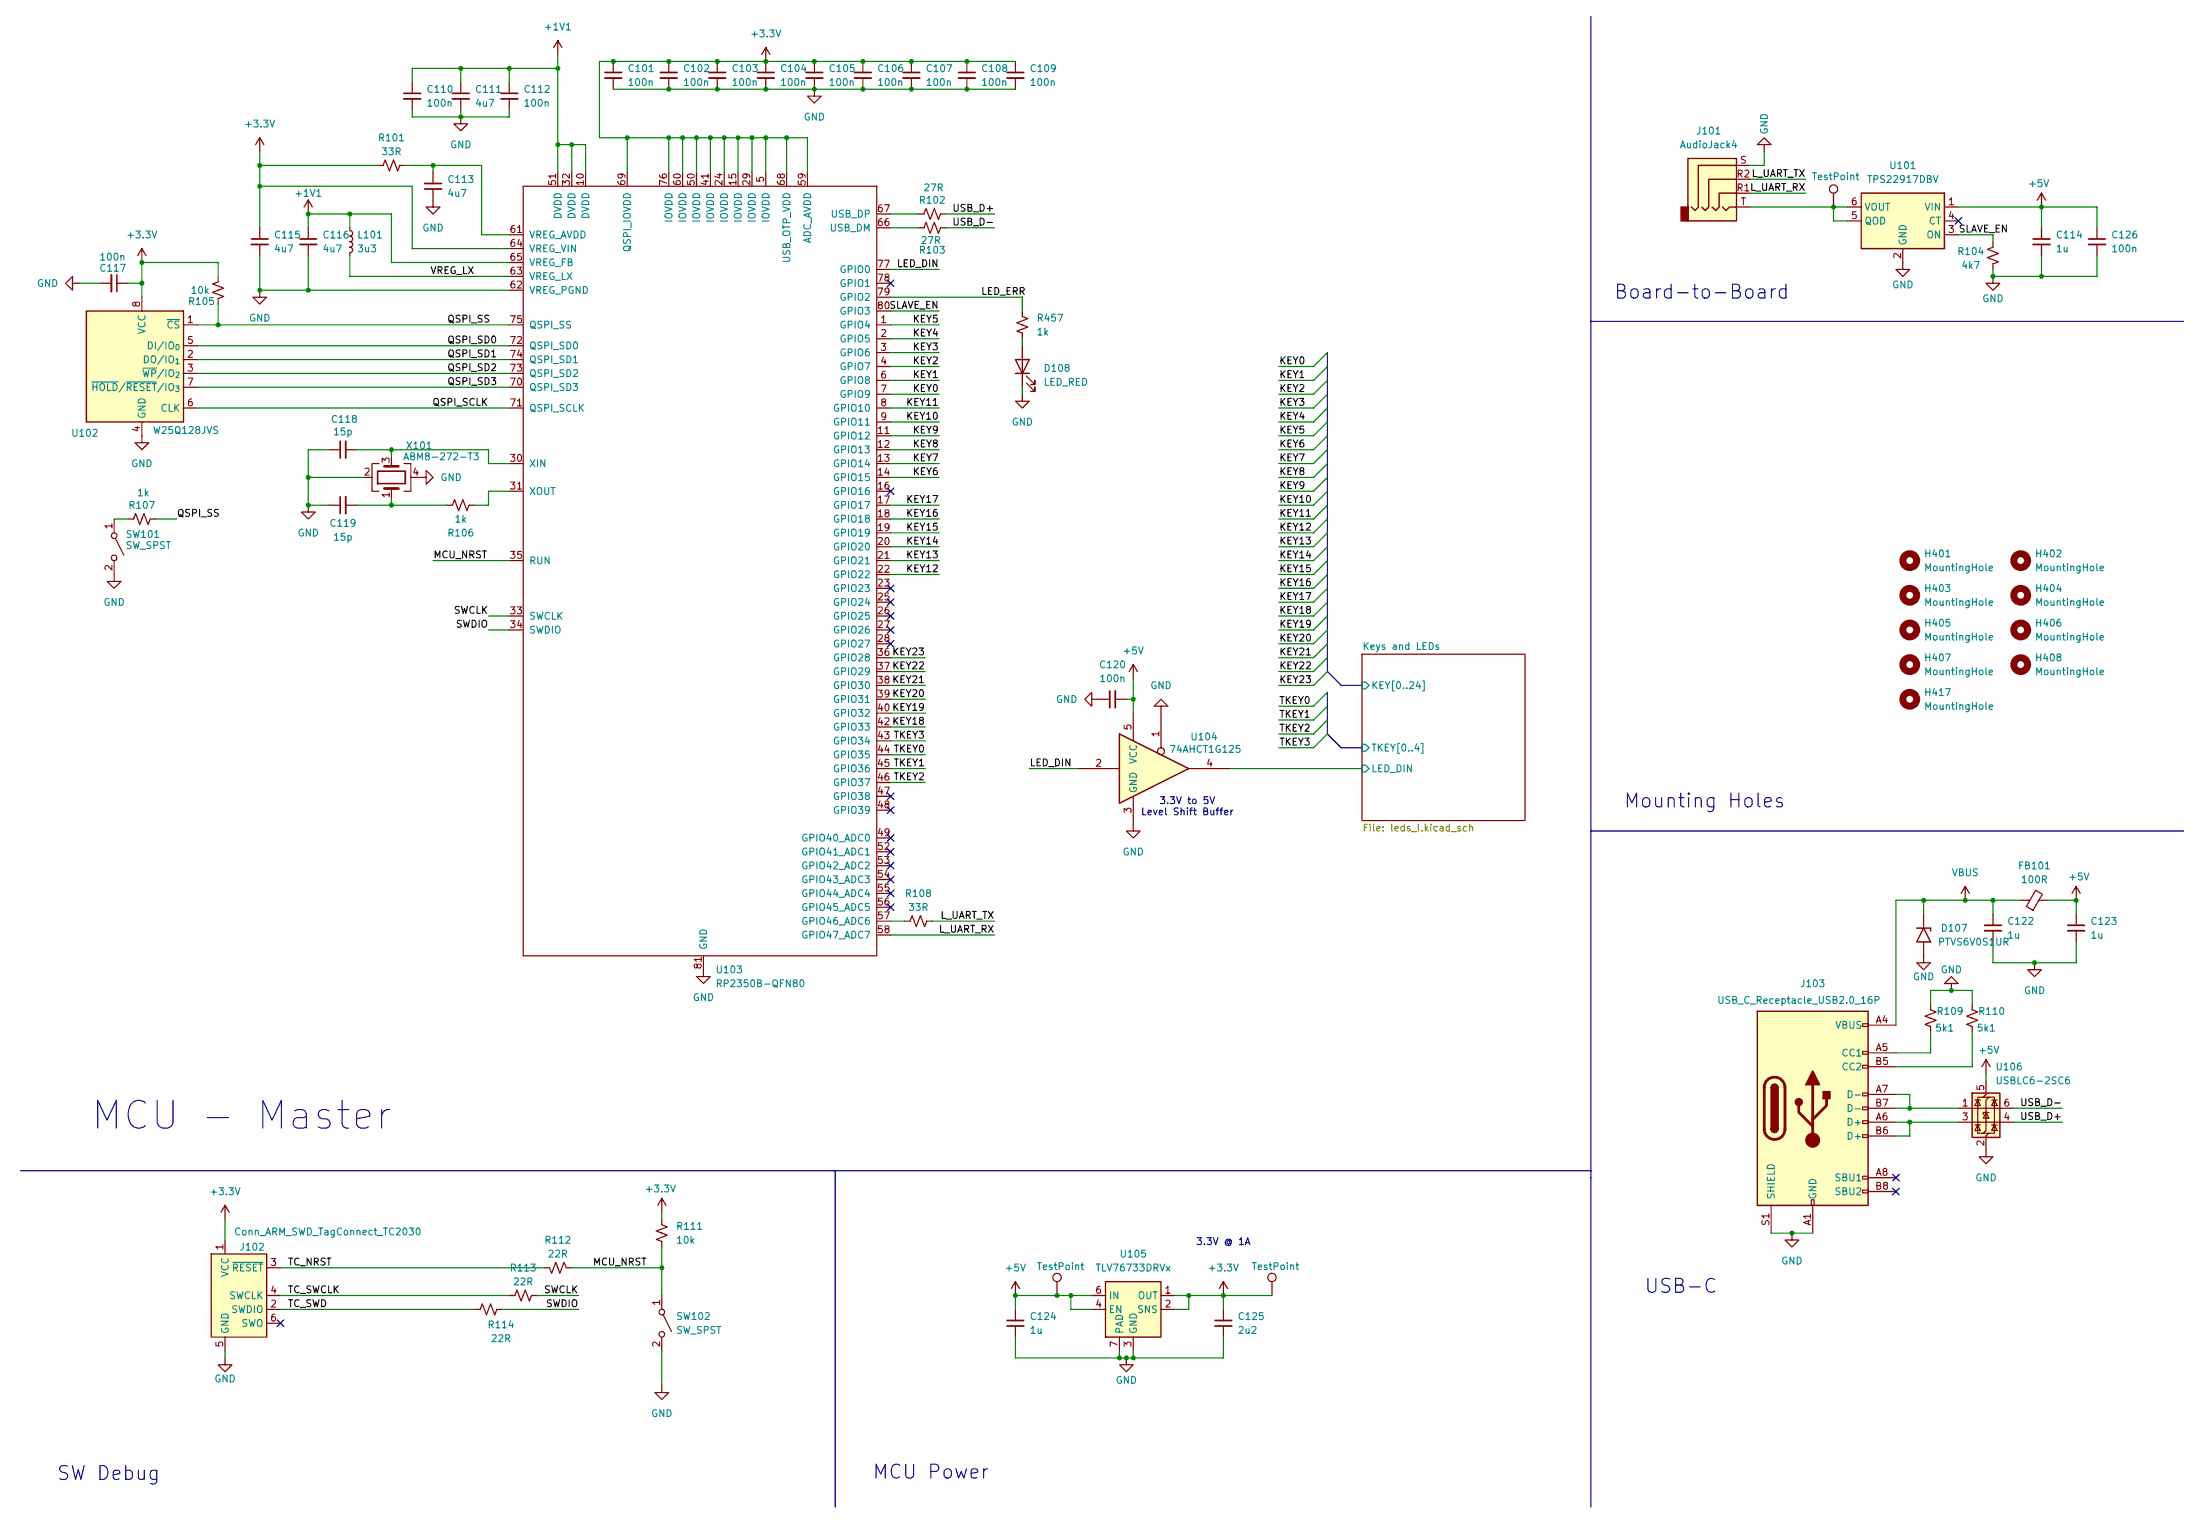
[picture p10: schematic left.kicad_sch]

Parts:
C101, C102, C103, C104, C105, C106, C107, C108, C109, C110, C112, C117, C120, C126: 100n; C_0402_1005Metric; LCSC C1525
C111, C113: 4u7; C_0402_1005Metric; LCSC C23733
C114, C122, C123, C124: 1u; C_0402_1005Metric; LCSC C52923
C115, C116: 4u7; C_0603_1608Metric; LCSC C19666
C118, C119: 15p; C_0603_1608Metric_Pad1.08x0.95mm_HandSolder; LCSC C1644
C125: 2u2; C_0402_1005Metric; LCSC C12530
D107: PTVS6V0S1UR; D_SOD-123; LCSC C18723426
D108: LED_RED; LED_0805_2012Metric; LCSC Part Number C965815
FB101: 100R; R_0805_2012Metric; LCSC C1015
H401, H402, H403, H404, H405, H406, H407, H408, H417: MountingHole; MountingHole_2.2mm_M2
J101: AudioJack4; Jack_3.5mm_PJ320D_Horizontal; LCSC C521460
J102: Conn_ARM_SWD_TagConnect_TC2030; Tag-Connect_TC2030-IDC-FP_2x03_P1.27mm_Vertical
J103: USB_C_Receptacle_USB2.0_16P; 918-318K2023S40000; LCSC C19189945
L101: 3u3; AOTA-B201610S3R3-101-T; LCSC C42411119
R101, R108: 33R; R_0402_1005Metric; LCSC C25105
R102, R103: 27R; R_0402_1005Metric; LCSC C25100
R104: 4k7; R_0402_1005Metric; LCSC C25900
R105, R111: 10k; R_0402_1005Metric; LCSC C25744
R106, R107: 1k; R_0402_1005Metric; LCSC C11702
R109, R110: 5k1; R_0402_1005Metric; LCSC C25905
R112, R113, R114: 22R; R_0402_1005Metric; LCSC C25092
R457: 1k; R_0402_1005Metric; LCSC Part Number C11702
SW101, SW102: SW_SPST; SPST_TS-1187A-B-A-B; LCSC C318884
TP101, TP102, TP103: TestPoint; TestPoint_Pad_1.0x1.0mm
U101: TPS22917DBV; SOT-23-6; LCSC C2681320
U102: W25Q128JVS; SOIC-8_5.3x5.3mm_P1.27mm; LCSC C97521
U103: RP2350B-QFN80; QFN-80-1EP_10x10mm_P0.4mm_EP3.4x3.4mm; LCSC C42415655
U104: 74AHCT1G125; SOT-23-5; LCSC C7484
U105: TLV76733DRVx; WSON-6-1EP_2x2mm_P0.65mm_EP1x1.6mm; LCSC C2848334
U106: USBLC6-2SC6; SOT-23-6; LCSC C2687116
X101: ABM8-272-T3; Crystal_SMD_3225-4Pin_3.2x2.5mm; LCSC C20625731

Connections:
+1V1: C110.1, C111.1, C112.1, C116.1, L101.1, U103.10 (DVDD), U103.32 (DVDD), U103.51 (DVDD), U103.65 (VREG_FB)
+3.3V: C101.1, C102.1, C103.1, C104.1, C105.1, C106.1, C107.1, C108.1, C109.1, C115.1, C117.1, C125.1, J102.1 (VCC), R101.1, R105.1, R111.1, TP103.1, U102.8 (VCC), U103.5 (IOVDD), U103.15 (IOVDD), U103.24 (IOVDD), U103.29 (IOVDD), U103.41 (IOVDD), U103.50 (IOVDD), U103.59 (ADC_AVDD), U103.60 (IOVDD), U103.64 (VREG_VIN), U103.68 (USB_OTP_VDD), U103.69 (QSPI_IOVDD), U103.76 (IOVDD), U105.1 (OUT), U105.2 (SNS)
+5V: C114.1, C120.2, C123.1, C124.1, C126.1, FB101.2, TP102.1, U101.1 (VIN), U104.5 (VCC), U105.4 (EN), U105.6 (IN), U106.5 (VBUS)
GND: C101.2, C102.2, C103.2, C104.2, C105.2, C106.2, C107.2, C108.2, C109.2, C110.2, C111.2, C112.2, C113.2, C114.2, C115.2, C116.2, C117.2, C118.1, C119.1, C120.1, C122.2, C123.2, C124.2, C125.2, C126.2, D107.2 (A2), D108.1 (K), J101.S, J102.5 (GND), J103.A1 (GND), J103.A12 (GND), J103.B1 (GND), J103.B12 (GND), J103.S1 (SHIELD), R104.2, R109.1, R110.1, SW101.2 (B), SW102.2 (B), U101.2 (GND), U102.4 (GND), U103.62 (VREG_PGND), U103.81 (GND), U104.1, U104.3 (GND), U105.3 (GND), U105.5 (GND), U105.7 (PAD), U106.2 (GND), X101.2, X101.4
KEY0: U103.7 (GPIO9)
KEY1: U103.6 (GPIO8)
KEY2: U103.4 (GPIO7)
KEY3: U103.3 (GPIO6)
KEY4: U103.2 (GPIO5)
KEY5: U103.1 (GPIO4)
KEY6: U103.14 (GPIO15)
KEY7: U103.13 (GPIO14)
KEY8: U103.12 (GPIO13)
KEY9: U103.11 (GPIO12)
KEY10: U103.9 (GPIO11)
KEY11: U103.8 (GPIO10)
KEY12: U103.22 (GPIO22)
KEY13: U103.21 (GPIO21)
KEY14: U103.20 (GPIO20)
KEY15: U103.19 (GPIO19)
KEY16: U103.18 (GPIO18)
KEY17: U103.17 (GPIO17)
KEY18: U103.42 (GPIO33)
KEY19: U103.40 (GPIO32)
KEY20: U103.39 (GPIO31)
KEY21: U103.38 (GPIO30)
KEY22: U103.37 (GPIO29)
KEY23: U103.36 (GPIO28)
LED_DIN: U103.77 (GPIO0), U104.2, U104.4
LED_ERR: R457.1, U103.79 (GPIO2)
L_UART_RX: J101.R1, U103.58 (GPIO47_ADC7)
L_UART_TX: J101.R2, R108.2
MCU_NRST: R111.2, R112.1, SW102.1 (A), U103.35 (RUN)
unnamed: C113.1, R101.2, U103.61 (VREG_AVDD)
unnamed: C118.2, U103.30 (XIN), X101.3
unnamed: C119.2, R106.2, X101.1
unnamed: D108.2 (A), R457.2
unnamed: J101.T, TP101.1, U101.5 (QOD), U101.6 (VOUT)
unnamed: J103.A5 (CC1), R109.2
unnamed: J103.A6 (D+), J103.B6 (D+), U106.3 (I/O2)
unnamed: J103.A7 (D-), J103.B7 (D-), U106.1 (I/O1)
unnamed: J103.B5 (CC2), R110.2
unnamed: R102.1, U103.67 (USB_DP)
unnamed: R103.1, U103.66 (USB_DM)
unnamed: R106.1, U103.31 (XOUT)
unnamed: R107.1, SW101.1 (A)
unnamed: R108.1, U103.57 (GPIO46_ADC6)
QSPI_SCLK: U102.6 (CLK), U103.71 (QSPI_SCLK)
QSPI_SD0: U102.5 (DI/IO_{0}), U103.72 (QSPI_SD0)
QSPI_SD1: U102.2 (DO/IO_{1}), U103.74 (QSPI_SD1)
QSPI_SD2: U102.3 (~WP/IO_{2}), U103.73 (QSPI_SD2)
QSPI_SD3: U102.7 (~HOLD/~RESET/IO_{3}), U103.70 (QSPI_SD3)
QSPI_SS: R105.2, R107.2, U102.1 (~CS), U103.75 (QSPI_SS)
SLAVE_EN: R104.1, U101.3 (ON), U103.80 (GPIO3)
SWCLK: R113.2, U103.33 (SWCLK)
SWDIO: R114.2, U103.34 (SWDIO)
TC_NRST: J102.3 (~RESET), R112.2
TC_SWCLK: J102.4 (SWCLK), R113.1
TC_SWD: J102.2 (SWDIO), R114.1
TKEY0: U103.44 (GPIO35)
TKEY1: U103.45 (GPIO36)
TKEY2: U103.46 (GPIO37)
TKEY3: U103.43 (GPIO34)
USB_D+: R102.2, U106.4 (I/O2)
USB_D-: R103.2, U106.6 (I/O1)
VBUS: C122.1, D107.1 (A1), FB101.1, J103.A4 (VBUS), J103.A9 (VBUS), J103.B4 (VBUS), J103.B9 (VBUS)
VREG_LX: L101.2, U103.63 (VREG_LX)

Notes on the sheet:
MCU - Master
USB-C
3.3V to 5V Level Shift Buffer
MCU Power
3.3V @ 1A
Mounting Holes
SW Debug
Board-to-Board
