Fredrik-Reinholdsen/Vesper/electronics/mcu_l.kicad_sch

## KiCad design electronics/mcu_l.kicad_sch (2026-06-29)

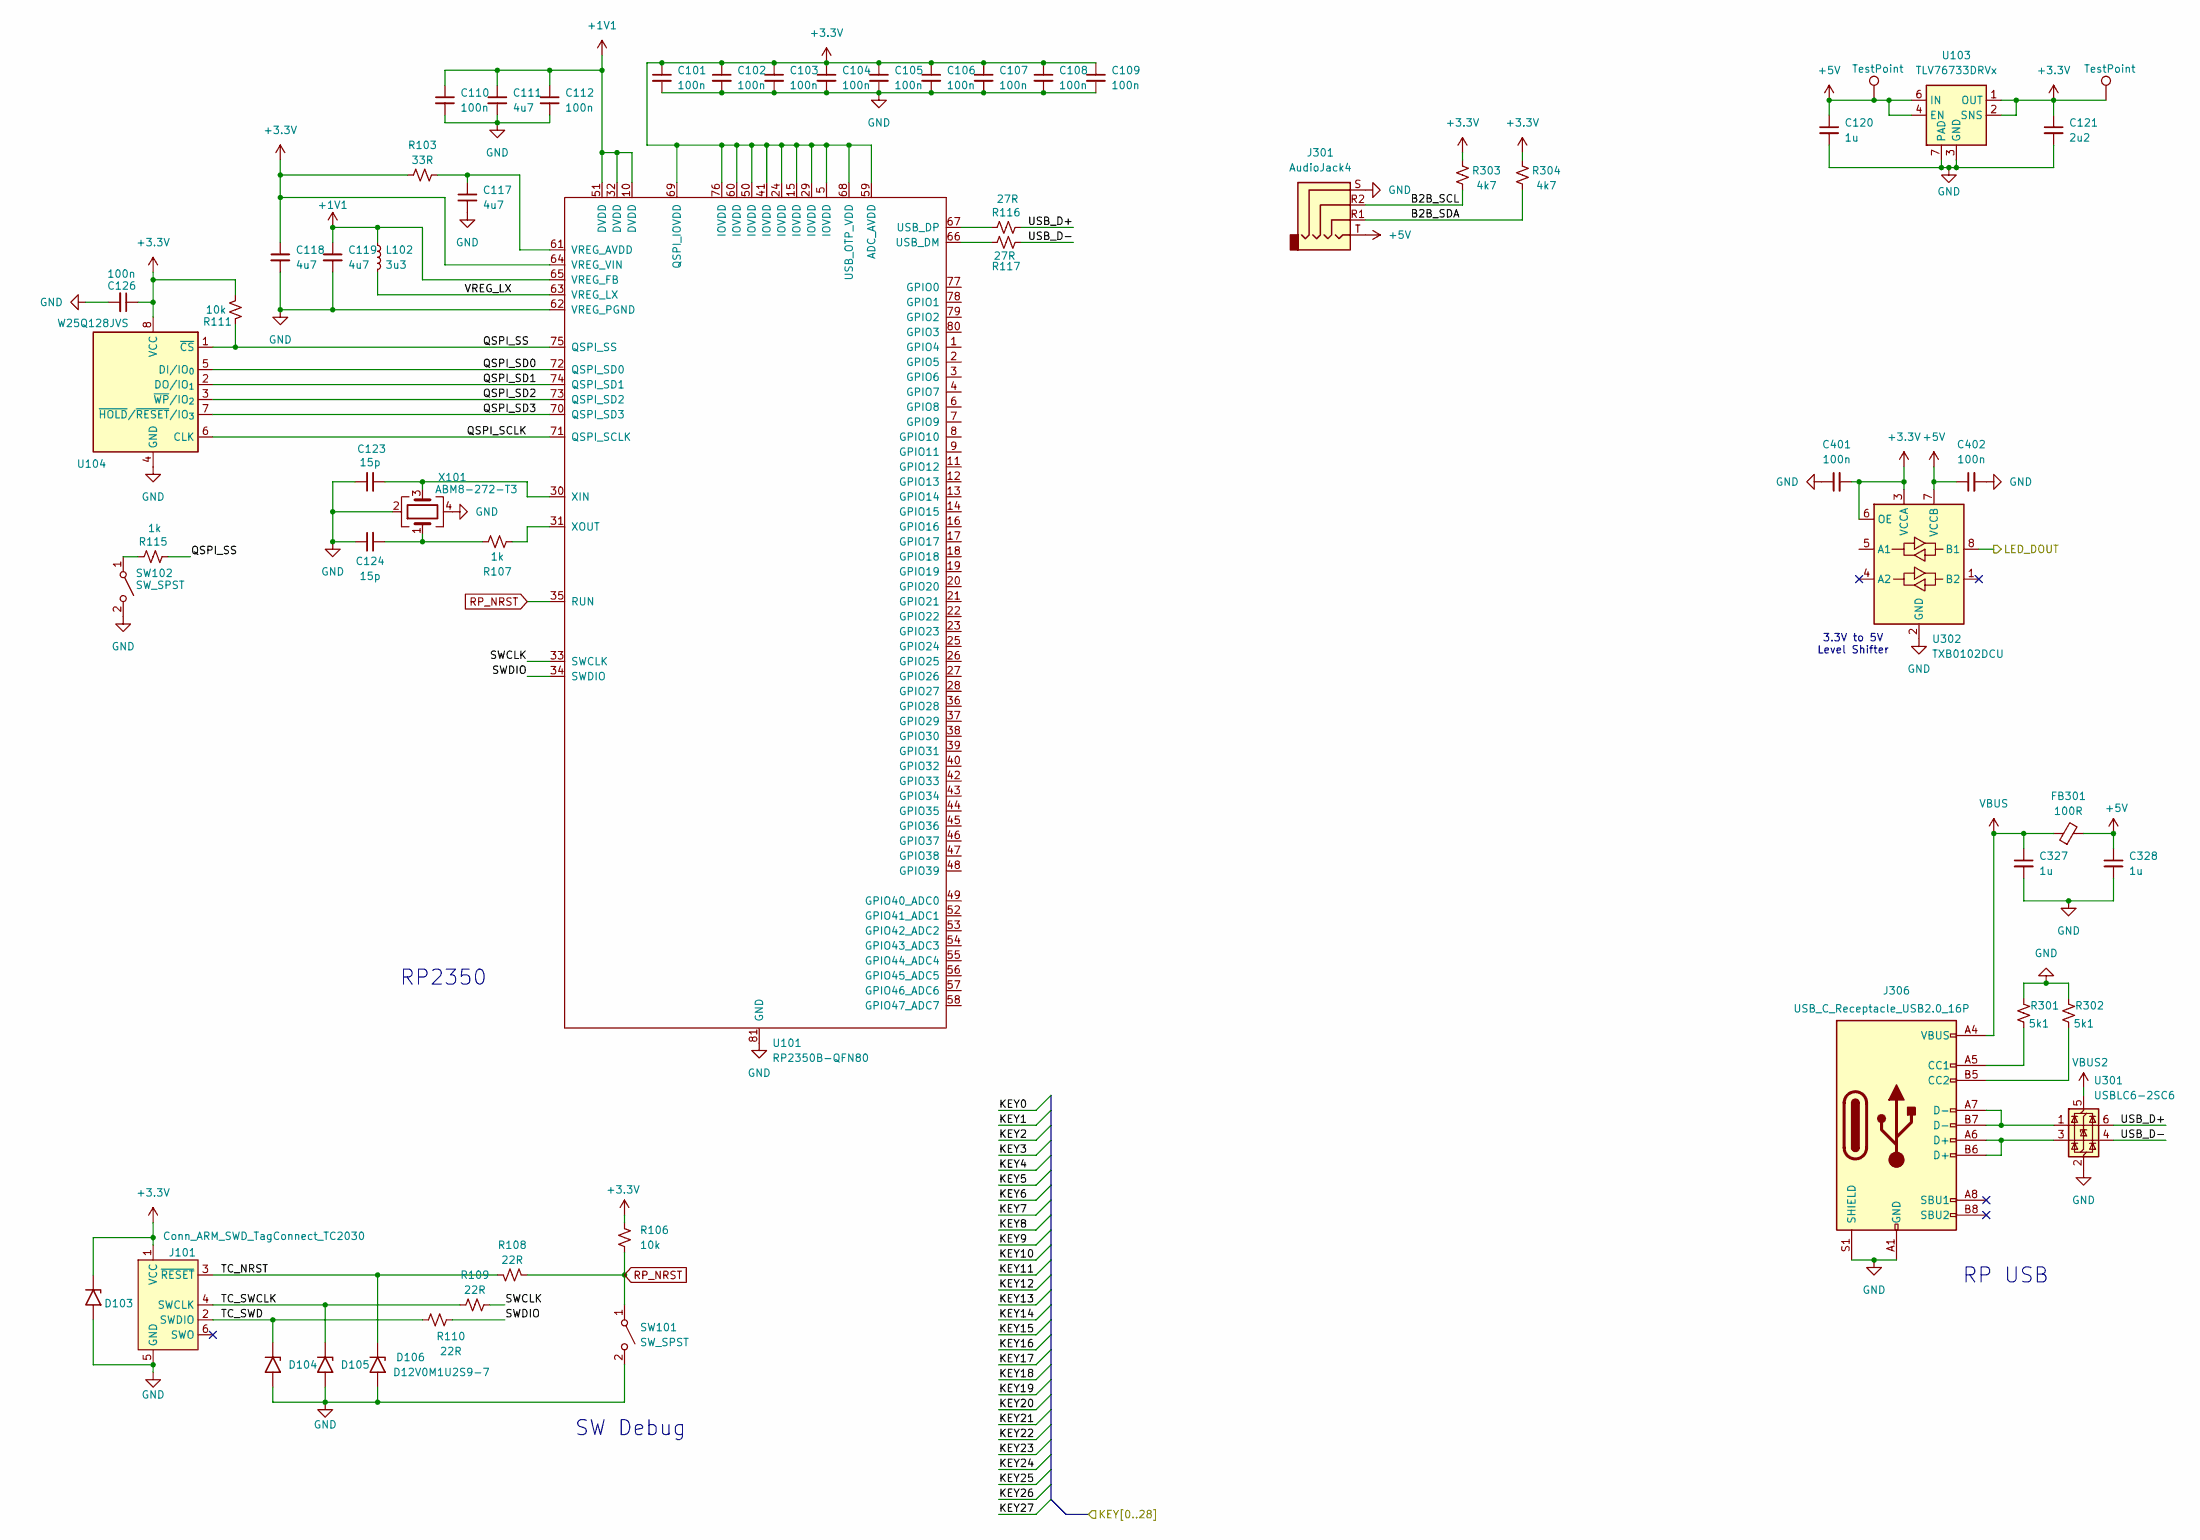
[picture p11: schematic mcu_l.kicad_sch]

Parts:
C101, C102, C103, C104, C105, C106, C107, C108, C109, C110, C112, C126, C401, C402: 100n; C_0402_1005Metric; LCSC C1525
C111, C117: 4u7; C_0402_1005Metric; LCSC C23733
C118, C119: 4u7; C_0603_1608Metric; LCSC C19666
C120, C327, C328: 1u; C_0402_1005Metric; LCSC C52923
C121: 2u2; C_0402_1005Metric; LCSC C12530
C123, C124: 15p; C_0603_1608Metric_Pad1.08x0.95mm_HandSolder; LCSC C1644
D103, D104, D105, D106: D12V0M1U2S9-7; D_SOD-923; LCSC C445497
FB301: 100R; R_0805_2012Metric; LCSC C1015
J101: Conn_ARM_SWD_TagConnect_TC2030; Tag-Connect_TC2030-IDC-FP_2x03_P1.27mm_Vertical
J301: AudioJack4
J306: USB_C_Receptacle_USB2.0_16P; 918-318K2023S40000; LCSC C19189945
L102: 3u3; AOTA-B201610S3R3-101-T; LCSC C42411119
R103: 33R; R_0402_1005Metric; LCSC C25105
R106, R111: 10k; R_0402_1005Metric; LCSC C25744
R107, R115: 1k; R_0402_1005Metric; LCSC C11702
R108, R109, R110: 22R; R_0402_1005Metric; LCSC C25092
R116, R117: 27R; R_0402_1005Metric; LCSC C25100
R301, R302: 5k1; R_0402_1005Metric; LCSC C25905
R303, R304: 4k7; R_0402_1005Metric; LCSC C11702
SW101, SW102: SW_SPST; SPST_TS-1187A-B-A-B; LCSC C318884
TP101, TP102: TestPoint; TestPoint_Pad_1.0x1.0mm
U101: RP2350B-QFN80; QFN-80-1EP_10x10mm_P0.4mm_EP3.4x3.4mm; LCSC C42415655
U103: TLV76733DRVx; WSON-6-1EP_2x2mm_P0.65mm_EP1x1.6mm_ThermalVias; LCSC C2848334
U104: W25Q128JVS; SOIC-8_5.3x5.3mm_P1.27mm; LCSC C97521
U301: USBLC6-2SC6; SOT-23-6; LCSC C2687116
U302: TXB0102DCU; VSSOP-8_2.3x2mm_P0.5mm
X101: ABM8-272-T3; Crystal_SMD_3225-4Pin_3.2x2.5mm; LCSC C20625731

Connections:
+1V1: C110.1, C111.1, C112.1, C119.1, L102.1, U101.10 (DVDD), U101.32 (DVDD), U101.51 (DVDD), U101.65 (VREG_FB)
+3.3V: C101.1, C102.1, C103.1, C104.1, C105.1, C106.1, C107.1, C108.1, C109.1, C118.1, C121.1, C126.1, C401.2, D103.1 (A1), J101.1 (VCC), R103.1, R106.1, R111.1, R303.1, R304.1, TP102.1, U101.5 (IOVDD), U101.15 (IOVDD), U101.24 (IOVDD), U101.29 (IOVDD), U101.41 (IOVDD), U101.50 (IOVDD), U101.59 (ADC_AVDD), U101.60 (IOVDD), U101.64 (VREG_VIN), U101.68 (USB_OTP_VDD), U101.69 (QSPI_IOVDD), U101.76 (IOVDD), U103.1 (OUT), U103.2 (SNS), U104.8 (VCC), U302.3 (VCCA), U302.6 (OE)
+5V: C120.1, C328.1, C402.1, FB301.2, J301.T, TP101.1, U103.4 (EN), U103.6 (IN), U302.7 (VCCB)
B2B_SCL: J301.R2, R303.2
B2B_SDA: J301.R1, R304.2
GND: C101.2, C102.2, C103.2, C104.2, C105.2, C106.2, C107.2, C108.2, C109.2, C110.2, C111.2, C112.2, C117.2, C118.2, C119.2, C120.2, C121.2, C123.1, C124.1, C126.2, C327.2, C328.2, C401.1, C402.2, D103.2 (A2), D104.2 (A2), D105.2 (A2), D106.2 (A2), J101.5 (GND), J301.S, J306.A1 (GND), J306.A12 (GND), J306.B1 (GND), J306.B12 (GND), J306.S1 (SHIELD), R301.1, R302.1, SW101.2 (B), SW102.2 (B), U101.62 (VREG_PGND), U101.81 (GND), U103.3 (GND), U103.5 (GND), U103.7 (PAD), U104.4 (GND), U301.2 (GND), U302.2 (GND), X101.2, X101.4
LED_DOUT: U302.8 (B1)
unnamed: C117.1, R103.2, U101.61 (VREG_AVDD)
unnamed: C123.2, U101.30 (XIN), X101.3
unnamed: C124.2, R107.2, X101.1
unnamed: J306.A5 (CC1), R301.2
unnamed: J306.A6 (D+), J306.B6 (D+), U301.3 (I/O2)
unnamed: J306.A7 (D-), J306.B7 (D-), U301.1 (I/O1)
unnamed: J306.B5 (CC2), R302.2
unnamed: R107.1, U101.31 (XOUT)
unnamed: R115.1, SW102.1 (A)
unnamed: R116.1, U101.67 (USB_DP)
unnamed: R117.1, U101.66 (USB_DM)
QSPI_SCLK: U101.71 (QSPI_SCLK), U104.6 (CLK)
QSPI_SD0: U101.72 (QSPI_SD0), U104.5 (DI/IO_{0})
QSPI_SD1: U101.74 (QSPI_SD1), U104.2 (DO/IO_{1})
QSPI_SD2: U101.73 (QSPI_SD2), U104.3 (~WP/IO_{2})
QSPI_SD3: U101.70 (QSPI_SD3), U104.7 (~HOLD/~RESET/IO_{3})
QSPI_SS: R111.2, R115.2, U101.75 (QSPI_SS), U104.1 (~CS)
RP_NRST: R106.2, R108.1, SW101.1 (A), U101.35 (RUN)
SWCLK: R109.2, U101.33 (SWCLK)
SWDIO: R110.2, U101.34 (SWDIO)
TC_NRST: D106.1 (A1), J101.3 (~RESET), R108.2
TC_SWCLK: D105.1 (A1), J101.4 (SWCLK), R109.1
TC_SWD: D104.1 (A1), J101.2 (SWDIO), R110.1
USB_D+: R116.2, U301.6 (I/O1)
USB_D-: R117.2, U301.4 (I/O2)
VBUS: C327.1, FB301.1, J306.A4 (VBUS), J306.A9 (VBUS), J306.B4 (VBUS), J306.B9 (VBUS)
VBUS2: U301.5 (VBUS)
VREG_LX: L102.2, U101.63 (VREG_LX)

Notes on the sheet:
RP2350
3.3V to 5V Level Shifter
SW Debug
RP USB
