Fredrik-Reinholdsen/Vesper/electronics/right.kicad_sch

## KiCad design electronics/right.kicad_sch (2026-06-29)

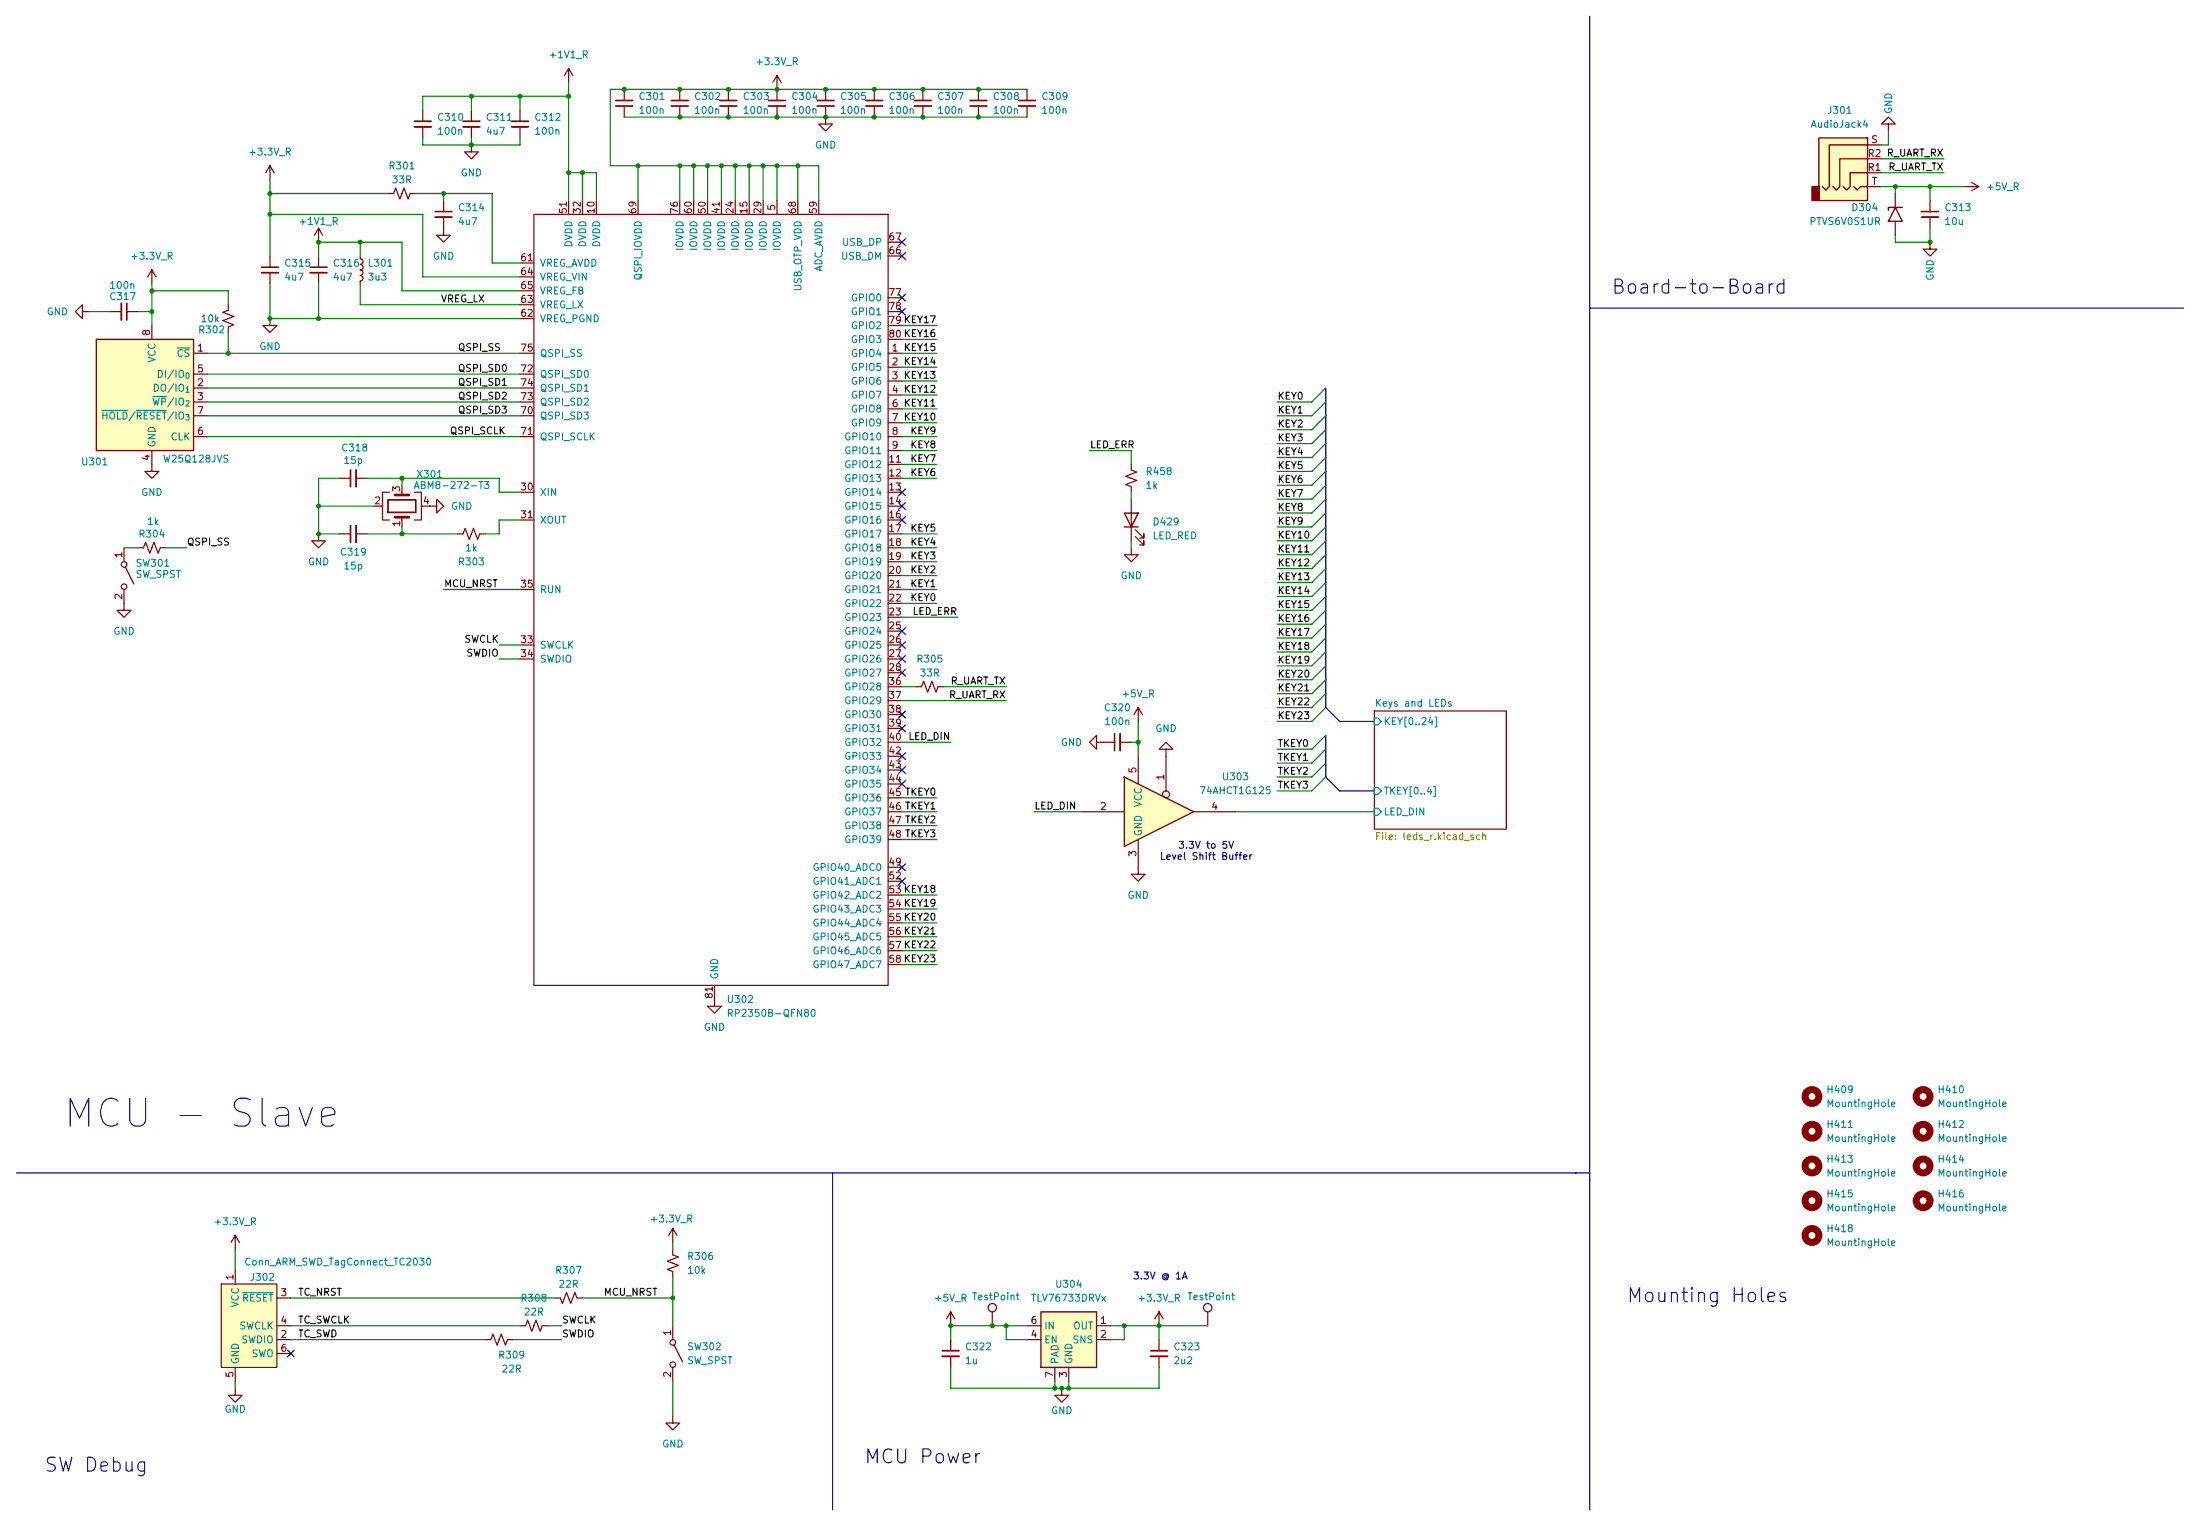
[picture p12: schematic right.kicad_sch]

Parts:
C301, C302, C303, C304, C305, C306, C307, C308, C309, C310, C312, C317, C320: 100n; C_0402_1005Metric; LCSC C1525
C311, C314: 4u7; C_0402_1005Metric; LCSC C23733
C313: 10u; C_0805_2012Metric; LCSC C15850
C315, C316: 4u7; C_0603_1608Metric; LCSC C19666
C318, C319: 15p; C_0603_1608Metric_Pad1.08x0.95mm_HandSolder; LCSC C1644
C322: 1u; C_0402_1005Metric; LCSC C52923
C323: 2u2; C_0402_1005Metric; LCSC C12530
D304: PTVS6V0S1UR; D_SOD-123; LCSC C18723426
D429: LED_RED; LED_0805_2012Metric; LCSC Part Number C965815
H409, H410, H411, H412, H413, H414, H415, H416, H418: MountingHole; MountingHole_2.2mm_M2
J301: AudioJack4; Jack_3.5mm_PJ320D_Horizontal; LCSC C521460
J302: Conn_ARM_SWD_TagConnect_TC2030; Tag-Connect_TC2030-IDC-FP_2x03_P1.27mm_Vertical
L301: 3u3; AOTA-B201610S3R3-101-T; LCSC C42411119
R301, R305: 33R; R_0402_1005Metric; LCSC C25105
R302, R306: 10k; R_0402_1005Metric; LCSC C25744
R303, R304: 1k; R_0402_1005Metric; LCSC C11702
R307, R308, R309: 22R; R_0402_1005Metric; LCSC C25092
R458: 1k; R_0402_1005Metric; LCSC Part Number C11702
SW301, SW302: SW_SPST; SPST_TS-1187A-B-A-B; LCSC C318884
TP301, TP302: TestPoint; TestPoint_Pad_1.0x1.0mm
U301: W25Q128JVS; SOIC-8_5.3x5.3mm_P1.27mm; LCSC C97521
U302: RP2350B-QFN80; QFN-80-1EP_10x10mm_P0.4mm_EP3.4x3.4mm; LCSC C42415655
U303: 74AHCT1G125; SOT-23-5; LCSC C7484
U304: TLV76733DRVx; WSON-6-1EP_2x2mm_P0.65mm_EP1x1.6mm; LCSC C2848334
X301: ABM8-272-T3; Crystal_SMD_3225-4Pin_3.2x2.5mm; LCSC C20625731

Connections:
+1V1_R: C310.1, C311.1, C312.1, C316.1, L301.1, U302.10 (DVDD), U302.32 (DVDD), U302.51 (DVDD), U302.65 (VREG_FB)
+3.3V_R: C301.1, C302.1, C303.1, C304.1, C305.1, C306.1, C307.1, C308.1, C309.1, C315.1, C317.1, C323.1, J302.1 (VCC), R301.1, R302.1, R306.1, TP302.1, U301.8 (VCC), U302.5 (IOVDD), U302.15 (IOVDD), U302.24 (IOVDD), U302.29 (IOVDD), U302.41 (IOVDD), U302.50 (IOVDD), U302.59 (ADC_AVDD), U302.60 (IOVDD), U302.64 (VREG_VIN), U302.68 (USB_OTP_VDD), U302.69 (QSPI_IOVDD), U302.76 (IOVDD), U304.1 (OUT), U304.2 (SNS)
+5V_R: C313.1, C320.2, C322.1, D304.1 (A1), J301.T, TP301.1, U303.5 (VCC), U304.4 (EN), U304.6 (IN)
GND: C301.2, C302.2, C303.2, C304.2, C305.2, C306.2, C307.2, C308.2, C309.2, C310.2, C311.2, C312.2, C313.2, C314.2, C315.2, C316.2, C317.2, C318.1, C319.1, C320.1, C322.2, C323.2, D304.2 (A2), D429.1 (K), J301.S, J302.5 (GND), SW301.2 (B), SW302.2 (B), U301.4 (GND), U302.62 (VREG_PGND), U302.81 (GND), U303.1, U303.3 (GND), U304.3 (GND), U304.5 (GND), U304.7 (PAD), X301.2, X301.4
KEY0: U302.22 (GPIO22)
KEY1: U302.21 (GPIO21)
KEY2: U302.20 (GPIO20)
KEY3: U302.19 (GPIO19)
KEY4: U302.18 (GPIO18)
KEY5: U302.17 (GPIO17)
KEY6: U302.12 (GPIO13)
KEY7: U302.11 (GPIO12)
KEY8: U302.9 (GPIO11)
KEY9: U302.8 (GPIO10)
KEY10: U302.7 (GPIO9)
KEY11: U302.6 (GPIO8)
KEY12: U302.4 (GPIO7)
KEY13: U302.3 (GPIO6)
KEY14: U302.2 (GPIO5)
KEY15: U302.1 (GPIO4)
KEY16: U302.80 (GPIO3)
KEY17: U302.79 (GPIO2)
KEY18: U302.53 (GPIO42_ADC2)
KEY19: U302.54 (GPIO43_ADC3)
KEY20: U302.55 (GPIO44_ADC4)
KEY21: U302.56 (GPIO45_ADC5)
KEY22: U302.57 (GPIO46_ADC6)
KEY23: U302.58 (GPIO47_ADC7)
LED_DIN: U302.40 (GPIO32), U303.2, U303.4
LED_ERR: R458.1, U302.23 (GPIO23)
MCU_NRST: R306.2, R307.1, SW302.1 (A), U302.35 (RUN)
unnamed: C314.1, R301.2, U302.61 (VREG_AVDD)
unnamed: C318.2, U302.30 (XIN), X301.3
unnamed: C319.2, R303.2, X301.1
unnamed: D429.2 (A), R458.2
unnamed: R303.1, U302.31 (XOUT)
unnamed: R304.1, SW301.1 (A)
unnamed: R305.1, U302.36 (GPIO28)
QSPI_SCLK: U301.6 (CLK), U302.71 (QSPI_SCLK)
QSPI_SD0: U301.5 (DI/IO_{0}), U302.72 (QSPI_SD0)
QSPI_SD1: U301.2 (DO/IO_{1}), U302.74 (QSPI_SD1)
QSPI_SD2: U301.3 (~WP/IO_{2}), U302.73 (QSPI_SD2)
QSPI_SD3: U301.7 (~HOLD/~RESET/IO_{3}), U302.70 (QSPI_SD3)
QSPI_SS: R302.2, R304.2, U301.1 (~CS), U302.75 (QSPI_SS)
R_UART_RX: J301.R2, U302.37 (GPIO29)
R_UART_TX: J301.R1, R305.2
SWCLK: R308.2, U302.33 (SWCLK)
SWDIO: R309.2, U302.34 (SWDIO)
TC_NRST: J302.3 (~RESET), R307.2
TC_SWCLK: J302.4 (SWCLK), R308.1
TC_SWD: J302.2 (SWDIO), R309.1
TKEY0: U302.45 (GPIO36)
TKEY1: U302.46 (GPIO37)
TKEY2: U302.47 (GPIO38)
TKEY3: U302.48 (GPIO39)
VREG_LX: L301.2, U302.63 (VREG_LX)

Notes on the sheet:
SW Debug
3.3V to 5V Level Shift Buffer
3.3V @ 1A
MCU Power
Mounting Holes
MCU - Slave
Board-to-Board
