Fredrik-Reinholdsen/Vesper/(commit log)

2026-06-29 Initial commit.
    [Vesper-L.stl, Vesper.FCStd, Vesper_L_Top.FCStd, leds_l.kicad_sch, leds_r.kicad_sch, left.kicad_sch, mcu_l.kicad_sch, right.kicad_sch]
2026-07-20 refactor: Refactor of slave binary to not mis button events due to bad use of select.
2026-07-20 feat: Added functionality to to reset master into USB bootloader mode for USB flashing.
    Holding top left and right 2 corner keys will reset the master keyboard into USB bootloader mode.
    Refactor of master code main.rs into smaller modules for readability.
    [hid.rs, keyboard.rs, led.rs, main.rs]
2026-07-20 feat: Added new cargo runner script when running master code with 'cargo run'. Script will check if connected RP2350 USB storage device is present, meaning keyboard is in USB bootloader mode, and if 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
